ttkpark/tomato-picker/docs/line-course/paper_shadow.jpg

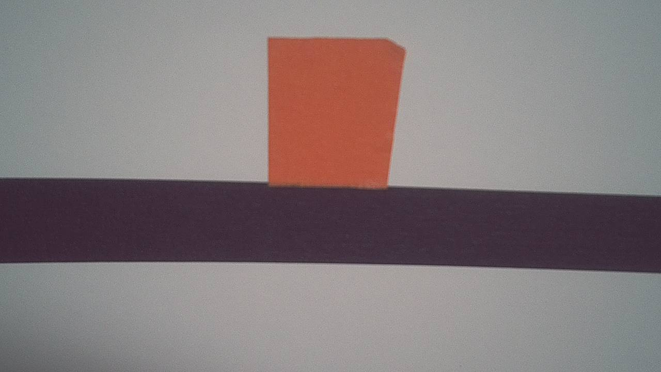
docs/line-course/paper_shadow.jpg
