ttkpark/tomato-picker/docs/line-course/paper_now.jpg

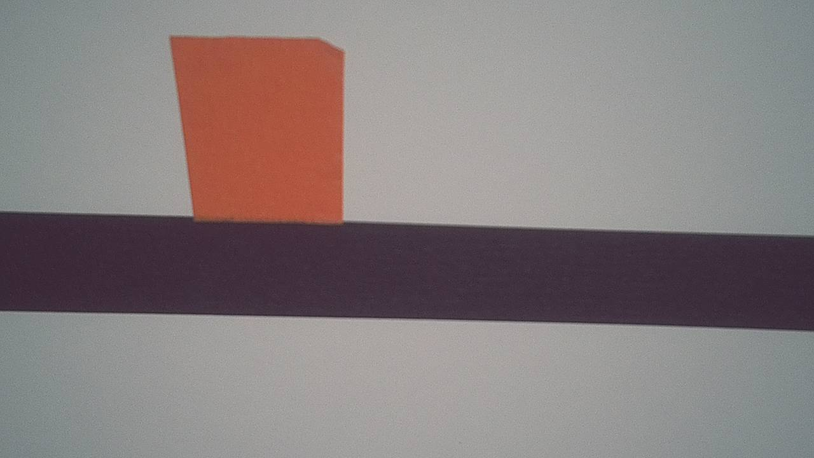
docs/line-course/paper_now.jpg
