ttkpark/tomato-picker/ros2/README.md

# ros2/ — 새 계통: **무대를 외우지 않고 좌표로 딴다**

> 이 디렉터리는 기존 파이썬 스택(`src/tomato_picker/`)을 **대체하러** 온 것이 아니라,
> 그 스택이 구조적으로 풀 수 없는 문제 하나를 풀러 왔다. 기존 스택은 계속 돈다.
> 계통 분리와 태그 규칙은 [`docs/ros2-이행계획.md`](../docs/ros2-이행계획.md).

---

## 1. 왜 갈아엎는가 — 기존 스택이 못 푸는 문제

지금 로봇은 토마토를 **화면 좌표**로 안다.

```
카메라 픽셀 (x, y)  →  harvest.SceneModel이 "몇 번 나무, 위/아래"로 분류
                    →  arm.play_blended(y)가 저장해 둔 자세를 보간 재생
```

여기 어디에도 **미터가 없다.** 그래서 이런 일이 일어난다.

| 증상 | 진짜 원인 |
|---|---|
| 무대를 옮기면 열매 번호가 어긋난다 | 나무 위치를 **관측한 픽셀 x**로 배운다 (`~/harvest_scene.json`) |
| 서비스를 재시작하면 학습이 날아간다 | 무대가 **상태**다. 재학습 첫 프레임이 오검출이면 그게 무대가 된다 |
| 열매가 20cm 앞으로 오면 헛집는다 | 자세는 **저장된 관절값**이다. 거리를 모르니 보정할 수 없다 |
| 카메라를 조금 돌리면 전부 틀어진다 | 픽셀↔자세 대응이 **그 카메라 각도에 통째로 묶여** 있다 |

이건 튜닝으로 못 고친다. **"토마토가 어디 있는가"를 미터로 말할 수 없는 구조**라서 그렇다.

## 2. 새 계통이 세우는 계약

```
D405가 준 (u, v, depth)  ──내부파라미터──▶  카메라 좌표 3D (mm)
                          ──손-눈 변환 T_base_cam──▶  팔 base 좌표 3D (mm)
                          ──IK──▶  관절 각
```

무대 학습이 없다. 저장된 자세도 없다. **좌표 하나가 끝까지 간다.**
무대를 옮겨도, 카메라를 다시 달아도, 열매가 처음 보는 자리에 있어도 같은 식이 돈다 —
단, **손-눈 변환을 다시 재야 한다**(카메라를 옮겼을 때만. 무대는 상관없다).

> 이게 "일반적인 환경에서도 변함없이"의 조작적 정의다. 무대에 대한 가정을
> **하나도 안 하는 것**이지, 무대를 더 잘 배우는 게 아니다.

## 3. 왜 ROS인가 — 세 가지, 그 이상은 아니다

ROS를 쓰는 이유는 "표준이니까"가 아니다. 위 계약을 **혼자 구현하면 반드시 틀리는**
부분이 셋 있어서다.

1. **TF** — 좌표계가 다섯 개(`base_link`, `arm_base`, 관절 5개, `tool0`, 카메라)를 넘어가면
   변환 합성과 **시각 정렬**(그 프레임을 찍은 순간의 팔 자세)을 사람이 손으로 못 맞춘다.
   기존 스택에서 `line_drive.py`가 겪은 부호 사고들이 전부 이 문제의 축소판이다.
2. **시간** — 깊이 프레임과 관절값은 **다른 시각**의 데이터다. 팔이 움직이는 중에 찍은
   프레임을 지금 관절값으로 풀면 그만큼 틀린다. `tf2`의 시간 보간이 이걸 공짜로 준다.
3. **교체 가능성** — 검출기를 HSV→YOLO로, 카메라를 D405→다른 것으로 바꿔도
   토픽 타입이 같으면 나머지가 안 바뀐다. [`docs/보드-계약.md`](../docs/보드-계약.md)가
   주행 보드에 대해 세운 원칙과 **같은 원칙**을 인식·팔에 적용하는 것이다.

ROS가 **안 하는 것**도 적어 둔다: 정지마찰 문턱을 없애 주지 않고, 영점을 대신 잡아
주지 않고, 잘못 잰 링크 길이를 고쳐 주지 않는다. 그건 여전히 우리 몫이다.

## 4. 단위 경계 — 어디서 무엇이 바뀌는가

이 프로젝트에는 이미 단위가 셋 있고, 섞이면 그 자리가 곧 버그다.

| 구간 | 단위 | 근거 |
|---|---|---|
| ROS 토픽·TF·URDF | **m, rad** | REP-103. 여기만은 타협 없음(모든 표준 노드가 이걸 가정) |
| 기구학·손눈보정 (`kinematics.py`, `handeye.py`) | **mm, °** | 기존 자산. 링크 길이를 자로 재서 넣는 곳이라 mm가 맞다 |
| 주행 보드 시리얼 | **mm/s, mdeg/s** | [`docs/보드-계약.md`](../docs/보드-계약.md) §2① |

변환은 **경계 노드 안에서 한 번만** 한다. 노드 내부에서 두 단위를 같이 쓰지 않는다.
경계는 정확히 세 곳이다 — `joint_state_node`(° → rad), `cmd_vel_node`(m/s → mm/s),
`handeye_node`(mm → m).

## 5. 구성

```
ros2/
├─ docker/            젯슨에서 도는 방법 (L4T 커널 위 Jazzy 컨테이너)
├─ src/
│  ├─ tomato_msgs         Fruit3D / FruitArray / 보정 서비스
│  ├─ tomato_description  URDF(xacro) — kinematics.py와 **같은 링크 길이**
│  ├─ tomato_bridge       기존 하드웨어를 ROS에 물리는 다리 (팔 관절 / cmd_vel)
│  ├─ tomato_perception   D405 → 열매 3D 점 (팔 좌표계로 변환해서 발행)
│  ├─ tomato_handeye      손-눈 보정 수집·풀이·static TF 발행
│  └─ tomato_bringup      런치와 파라미터
└─ tools/ros_selfcheck.py  **ROS 없이 PC에서 도는 검증** (아래)
```

### 왜 `ros_selfcheck.py`가 있는가

이 저장소의 규칙이다 — [`kinematics.py`](../src/tomato_picker/hardware/kinematics.py)가
`import math` 하나로 버티는 이유, [`handeye.py`](../src/tomato_picker/hardware/handeye.py)가
numpy 하나로 버티는 이유와 같다. **숫자가 맞는지를 확인하려고 매번 젯슨에 올려 팔을
흔들 수는 없다.** 그래서 각 패키지의 계산 부분은 `rclpy`를 import하지 않는 순수 모듈로
떼어 놓고, PC에서 이걸 돌린다.

```bash
python ros2/tools/ros_selfcheck.py        # ROS도 젯슨도 필요 없음 (69종)
```

패키지 안에서 `rclpy`가 들어간 파일은 `*_node.py` **뿐이다.** 그 규칙을 셀프체크가
직접 검사한다.

검사는 두 층이다 — 아래쪽이 위쪽의 구멍을 막는다.

| 어디서 | 무엇을 | 구멍 |
|---|---|---|
| PC | `ros2/tools/ros_selfcheck.py` — xacro를 **직접 파싱해** 계산한 값과 대조 | 내가 xacro를 잘못 읽었으면 검사도 같이 틀린다 |
| 로봇 | `ros2/tools/bringup_check.sh` → `tf_check.py` — **진짜 RSP가 만든 TF**와 대조 | 그 구멍을 막는다. 팔·카메라 없이 돈다 |

```bash
# 컨테이너 안에서 (팔도 카메라도 필요 없다)
sudo HOME="$HOME" docker compose run --rm ros bash /ws/tools/bringup_check.sh
```

## 6. 지금 되는 것 / 아직 아닌 것

| | 상태 |
|---|---|
| URDF·TF 트리, `/joint_states` 발행 | ✅ 1단계 |
| `/cmd_vel` → 주행 보드 (보드계약 `C`, 레거시 `V` 폴백) | ✅ 1단계 |
| D405 → 열매 3D 점을 **팔 좌표계로** 발행 | ✅ 1단계 |
| 손-눈 보정 수집·풀이·static TF | ✅ 1단계 |
| 좌표로 집으러 가기(IK 실행) | ✅ 1단계 (`/arm/move_to_point`) |
| 마커로 집게를 눈으로 보며 오차 닫기(시각 서보잉) | ⏳ 2단계 |
| MoveIt 궤적·충돌 회피 | ⏳ 3단계 |

단계와 태그 대응은 [`docs/ros2-이행계획.md`](../docs/ros2-이행계획.md).

## 7. ⚠ 장치는 배타적이다 — 켜기 전에 자리를 비운다

포트도 카메라도 **한 프로세스만** 연다. 설정이 아니라 물리다.

| 장치 | 레거시가 잡는 것 | ROS가 잡는 것 |
|---|---|---|
| `/dev/ttyACM0` (팔) | `tomato-voice.service` | `arm_node` |
| `/dev/ttyUSB0` (주행 보드) | `controller-drive.service` | `cmd_vel_node` |
| **D405** | `depth-cam.service` (`/dev/shm`) | `realsense2_camera` |

```bash
sudo systemctl stop tomato-voice depth-cam      # 팔 + 카메라
sudo systemctl stop controller-drive            # 주행까지 쓸 때
```

`arm_mode:=proxy`는 **레거시 대시보드를 켜 둔 채 배선만 확인하는** 임시 경로다.
관절값이 HTTP 폴링(~10Hz)이라 **TF 시각 정렬이 안 되므로** 보정·수확에는 쓰지 마라
(`v2.0.0-ros.3`에서 삭제). 포트가 막히면 도망갈 곳이 아니라 **끌 서비스**를 봐라.

## 8. 레거시와 무엇을 공유하고 무엇을 안 하는가

한 줄로: **계산과 실측값은 공유하고, 장치와 상태의 소유권은 ROS가 가지며, 웹
서비스에는 붙지 않는다.**

기구학을 여기 다시 쓰면 같은 팔을 두 계통이 다르게 믿게 된다 — 그래서
`kinematics.py`·`handeye.py`·`cartesian.py`·`eye.EyeConfig`는 **계속 쓴다**.
그건 라이브러리를 쓰는 것이지 옛 계통을 따라가는 것이 아니다. 반대로 팔을 여는 일,
보드에 쓰는 일, 카메라를 잡는 일은 ROS가 가져왔다.

보정 파일은 **한 벌**이다(`~/arm_eye.json`). 대시보드에서 잡은 보정을 ROS가 그대로
쓰고, 그 반대도 같다 — 팔도 카메라도 하나뿐이므로.

전체 표와 언제 무엇을 끊는지는
[`docs/ros2-이행계획.md`](../docs/ros2-이행계획.md) §4 "레거시 의존 졸업표".
그 표는 `ros2/tools/ros_selfcheck.py`의 **[경계]** 검사가 강제한다 — 표에 없는
의존이 들어오면 실패한다.
