ttkpark/tomato-picker/docs/arm-cartesian.md

# 팔 3D 좌표 유닛 — xyz 이동과 제자리 회전

집게가 문 물건을 **로봇 좌표 xyz로 옮기고, 그 자리에서 돌린다.**
프리셋(저장한 자세 재생)이 못 하던 "5mm만 더 앞으로", "문 채로 30° 돌려"가 여기서 된다.

| 파일 | 하는 일 |
|---|---|
| [`hardware/kinematics.py`](../src/tomato_picker/hardware/kinematics.py) | 순/역기구학. **import가 `math` 하나** — 팔 없이 PC에서 검증 가능 |
| [`hardware/cartesian.py`](../src/tomato_picker/hardware/cartesian.py) | 유닛 본체 — 정규화값↔각도, 영점, 안전검사, 조그/회전/집게 |
| [`hardware/arm.py`](../src/tomato_picker/hardware/arm.py) `_FollowerJointIO` | 실물 팔에 붙이는 어댑터 (`arm.cartesian`) |
| [`tools/arm_cartesian_check.py`](../tools/arm_cartesian_check.py) | 하드웨어 없이 도는 자체검증 33종 |
| `/control` 3D 좌표 이동 · `/settings` 3D 좌표 영점 | 화면 |

---

## 1. 좌표계 — 무엇이 x이고 무엇이 y인가

```
        +z 위
         │
         │        원점 = shoulder_pan(요) 축이 바닥판을 지나는 점
         │        +x = pan=0일 때 팔이 뻗는 방향(앞)
         └──── +x 앞      +y = 왼쪽
        /
      +y 왼

pitch = 집게 축이 수평에서 들린 각   (0° = 수평, -90° = 바닥을 봄)
roll  = 집게 축을 중심으로 한 비틀림 (= wrist_roll 그대로)
```

관절 각의 **기준은 수평**이다(`shoulder_lift = 0°`면 상완이 수평).
이것과 **영점을 잡을 때 두는 자세(교시 자세)** 는 별개다 — 아래 3절.

---

## 2. ⚠ 이 팔이 못 하는 것 — 5축이라 6자유도가 안 나온다

**집게가 향하는 좌우 방향(yaw)은 위치에 묶여 있다.** `shoulder_pan`은 팔 전체를
돌리므로 집게는 항상 원점에서 바깥을 향한다. 그래서 "물체를 제자리에서 좌우로
비틀기"는 일반적으로 **불가능**하다.

**딱 하나 예외** — 집게가 바닥을 볼 때(`pitch ≈ -90°`)는 집게 축이 곧 수직축이라
`wrist_roll`이 그대로 yaw가 된다. 위에서 내려다보며 집는 자세에서는 제자리 yaw가
공짜로 된다. 화면의 [돌리기 ↺/↻]는 이 구간에서만 열리고, 아니면 왜 안 되는지
말해준다.

그래서 제자리 회전은 **세 가지**다:

| 화면 버튼 | 축 | 되는 조건 | 어떻게 |
|---|---|---|---|
| 비틀기 ↺↻ | roll | 언제나 | `wrist_roll` 하나만 돈다 — 가장 확실 |
| 손목 들기/숙이기 | pitch | 사거리 안이면 | IK로 **끝점을 고정한 채** 손목 각만 바꾼다 |
| 돌리기 ↺↻ | yaw | `pitch ≈ -90°`일 때만 | roll을 반대 부호로 돌린다 |

---

## 3. 처음 한 번 — 영점 잡기 (안 하면 좌표 이동이 아예 안 열린다)

`/settings` → **3D 좌표 영점**

1. **부호 먼저.** [① 힘 빼기] 후 관절을 하나씩 손으로 움직이며 화면의 각도 숫자를 본다.
   - `shoulder_lift` — 상완을 **위로** 들 때 숫자가 커져야 한다
   - `elbow_flex` — 전완을 **위로** 접을 때 커져야 한다
   - `wrist_flex` — 집게를 **위로** 젖힐 때 커져야 한다
   - `shoulder_pan` — **왼쪽**으로 돌 때 커져야 한다
   - `wrist_roll` — 반시계로 비틀 때 커져야 한다

   반대로 가는 관절만 [뒤집기]. **부호가 틀리면 "위로"가 아래로 간다** — 영점보다 먼저 맞춘다.

2. **링크 길이.** 자로 잰다(축과 축 사이, mm). 5분이면 된다.
   `z0`=바닥판→어깨축, `l1`=어깨→팔꿈치, `l2`=팔꿈치→손목,
   `l3`=손목→**집게가 무는 지점**(손끝이 아니다).
   틀리면 조그 **방향은 맞고 크기만** 비례해서 어긋나고, 절대 좌표 이동은 그만큼 틀린다.

3. **영점 — 어깨는 정면, 나머지는 곧게 위로.**
   힘 뺀 팔의 어깨(`shoulder_pan`)를 정면으로 두고, **상완·전완·집게를 한 줄로 수직**
   으로 세운다(팔꿈치·손목을 꺾지 않는다). 그 자세에서 [② 지금 자세를 영점으로].
   기구학 각도로는 `pan 0 / lift 90 / elbow 0 / wrist_flex 0`
   (= `config.ARM_CART_ZERO_POSE_DEG`, 파일에도 `ref_deg`로 함께 기록된다).

   > **왜 수평이 아니라 수직인가** (2026-08-22 현장에서 바꿈)
   > - 힘을 빼면 **중력이 수평 팔을 끌어내린다.** 손으로 붙들고 버튼을 누르는 사이
   >   이미 몇 도가 처지고, 그 처짐이 그대로 영점 오차가 된다.
   > - **수직은 기준선이 있다.** 문틀·벽 모서리에 대보면 1° 안쪽으로 맞는다.
   >   수평은 기준이 없어 사람마다, 누를 때마다 다르게 잡힌다.

   > ⚠ **세운 직후에는 조그가 막힌다 — 정상이다.** 그 자세는 집게가 회전축 바로 위
   > (수평거리 0)라 "앞"이 어느 쪽인지 정의되지 않는 **특이점**이다. 프리셋으로 앞으로
   > 뻗은 자세를 만든 뒤 좌표 이동을 쓴다.

결과는 `~/arm_cartesian.json`에 남는다. `config.py`의 값은 공장 초기값이고,
이 파일이 있으면 **파일이 이긴다**(`~/base_tuning.json`과 같은 구조).

> ⚠ **팔 범위 캘리브레이션을 다시 하면 이 영점도 다시 잡아야 한다.**
> 정규화값(-100..100)이 무슨 각도인지가 통째로 바뀌기 때문이다.
> 프리셋 숫자가 다른 자세를 가리키게 되는 것과 같은 이유다.

---

## 4. 쓰는 법

**화면** — `/control` → **3D 좌표 이동**

- 이동 스텝(mm) / 회전 스텝(°) 슬라이더 → 축 버튼 한 번에 그만큼
- **집게 기준으로 움직이기** 체크 → 로봇 xyz 대신 집게 기준
  (앞=찔러넣기, 위=집게 기준 위). 비스듬히 든 집게로 열매에 똑바로 다가갈 때 쓴다.
  체크하면 버튼 라벨도 같이 바뀐다 — 어느 기준으로 누르는지 헷갈리면 안 되니까.
- 좌표로 직접: [지금 값 채우기] → 숫자 고침 → [여기로]

**코드**

```python
arm.cartesian.jog(dz=10)                      # 위로 10mm
arm.cartesian.jog(dx=20, frame="tool")        # 집게가 보는 쪽으로 20mm
arm.cartesian.move_to(x=210, z=140)           # 절대 좌표(안 준 축은 유지)
arm.cartesian.spin(30, axis="roll")           # 문 채로 30° 비틀기
arm.cartesian.spin(-15, axis="pitch")         # 끝점 고정하고 손목만 숙이기
arm.cartesian.spin(90, axis="yaw")            # 내려다보는 자세에서만
arm.cartesian.set_grip(0)                     # 집게 닫기(0=닫힘, 100=열림)
pose = arm.cartesian.pose()                   # ToolPose(x, y, z, pitch, roll)
```

**집게는 좌표 이동이 절대 건드리지 않는다.** 매 조그마다 집게에 새 목표를 주면
눌린 현재값을 목표로 다시 써서 무는 힘이 조금씩 풀리고, 몇 번 반복하면 떨어뜨린다.
집게는 `set_grip()`으로 명시적으로 요청할 때만 움직인다.

---

## 5. 안 움직일 때 — 이유는 항상 화면에 뜬다

이 유닛은 **못 가는 곳으로 되는 데까지 가지 않는다.** 전부 거절하고 이유를 말한다.

| 메시지 | 뜻 | 조치 |
|---|---|---|
| 너무 작아서 실제로는 안 움직입니다 | 필요한 관절 변화가 서보 분해능(0.088°/틱) 근처 | 스텝을 키운다 |
| 한 번에 N mm는 너무 큽니다 | 좌표 오타 방어(상한 80mm) | 나눠서 간다 |
| 거기까지 못 갑니다 — 사거리 밖 | IK가 안 풀린다 | 가깝게 잡거나 pitch를 바꾼다 |
| 관절 가동범위를 벗어납니다: … | 그 관절이 캘리브레이션된 끝 | 그 방향으로는 끝 |
| 바닥 아래입니다 / 몸통에 너무 가깝습니다 | 작업영역 밖 | — |
| 팔이 거의 수직으로 서 있습니다 | 영점 자세 그대로 — 회전축 위라 방향이 없다 | 프리셋으로 앞으로 뻗은 자세부터 |
| 팔이 몸통 뒤로 넘어가 있습니다 | 끝점이 pan 축 뒤로 넘어가 좌표가 뒤집히는 구간 | 〃 |
| 기구학 영점이 없습니다 | 3번을 안 했다 | `/settings`에서 등록 |

> **왜 이렇게 깐깐한가** — CLAUDE.md의 "지령은 나가는데 아무 일도 안 일어난다"가
> 이 로봇의 1번 병이고, 서보에도 같은 문턱이 있다. 0.1mm 조그는 관절로 0.02°,
> 서보 1틱(0.088°) **아래**라 물리적으로 0이다. 그걸 "완료"라고 말하면 사람이
> 게인을 만지기 시작하고, 한 시간이 사라진다.

---

## 6. 팔 없이 검증하기

```bash
python tools/arm_cartesian_check.py
```

기구학 왕복(무작위 2만 자세) · 조그가 요청한 방향으로 요청한 만큼 가는지 ·
제자리 회전이 정말 제자리인지(끝점 이동 0mm) · 안전 검사가 실제로 막는지 ·
교시 자세(곧게 세운 팔)를 영점으로 잡으면 각도와 좌표가 맞게 나오는지 —
**33가지를 하드웨어 없이** 확인한다. 대시보드도 Mock 팔에 같은 유닛이 붙어 있어
(`SimJointIO`) 화면과 왕복을 PC에서 그대로 눌러볼 수 있다.

부호·라디안/도·왕복 불일치 같은 실수는 실물에서 확인할 이유가 없다 — 그건
부러진 집게로 배우게 된다.
