ttkpark/tomato-picker/PROJECT_토마토로봇.md

# PROJECT — 토마토 따기 로봇 (LG Physical AI 부스)

> 프로젝트 마스터 문서. 현황·팀·하드웨어·아키텍처·할 일·일정을 한 곳에. (수시 갱신)
> 최종 갱신: 2026-06-26

---

## 한 줄 요약
음성 명령을 LLM이 받아 로봇이 익은 토마토를 직접 보고 따서 바구니에 담는 **체험형 피지컬 AI 데모**.
메시지: *"쉽게 구할 수 있는 로봇팔로도 피지컬 AI가 가능하다."*

## 기본 정보
| 항목 | 내용 |
|---|---|
| 의뢰 | 포너즈 → 박기호 |
| 공동진행 | 용용이님 |
| 용도 | LG AI 컨퍼런스 체험형 부스 레퍼런스(데모) |
| 마감 | **2026-08-초** (가용 약 1~1.5개월) |
| 예산 | 300~400만원 (단위 확인 필요) / 집행 약 135만원 |
| 상태 | 🟢 부품 대부분 입고 · **조립 진행 중** |

---

## 현황 (Status)
- ✅ 컨셉/아키텍처 확정 (2026-06-24)
- ✅ 핵심 장비 발주·입고
- ✅ **카메라 발주·도착** (이전 블로커 해소)
- ✅ 추가 부품 도착 — NVMe 스토리지·와이파이 안테나·삼각대·컴퓨터 케이스
- 🟢 **조립 진행 중** (로봇팔 제외 전 부품 도착) — 작업 영상도 기록 중 🎥
- 🟡 로봇팔(SO-ARM101) 도착 대기
- 🟡 전원/파워(UPS) — 조만간 구매 예정
- 🟡 젯슨 오린 세팅 예정
- 🔴 제어 / 인식 / 수확 알고리즘 미착수

---

## 설계 원칙 (안정성 최우선)
부스 데모는 결정적이어야 한다. **"AI"는 딱 두 층에만** 둔다.
1. 익은 열매 인식 — 색 기반 검출 (빨강=수확 / 초록=미수확)
2. 자연어 → 함수 계획 — LLM(Claude) 함수콜 오케스트레이션

나머지(이동·집기)는 **전부 하드코딩/결정적**.
- 무대: 나무 모형 3개 일렬, 열매 위치 자석 고정.
- 이동: 메카넘 베이스 **직선 운동만** (자유주행 X).
- 따기: 사전 정의 시퀀스 재생.

## 아키텍처
```
음성 명령
  └─> Claude (함수콜 오케스트레이션)
        ├─ drive_to_tree(id)   직선 이동
        ├─ scan_tree()         카메라 색검출 → [열매: 위치·익음]
        ├─ pick_fruit(id)      따기 시퀀스
        ├─ place_in_basket()   바구니 적재
        └─ home()              복귀
              └─> 하드웨어: 팔 + 이동베이스 + 카메라
```
예) "수확 가능한 모든 열매를 수확해" → 나무 순회하며 빨강 열매만 수확.

---

## 하드웨어
| 구분 | 품목 | 상태 |
|---|---|---|
| 로봇팔 | LeRobot SO-ARM101 Max (Feetech 서보) | 🟡 도착 대기 |
| 연산보드 | NVIDIA Jetson Orin Nano Super 개발자킷 | ✅ 입고 |
| 스토리지 | NVMe 128GB (중고) | ✅ 입고 |
| 케이스 | 젯슨 오린 나노 NX 케이스 + 컴퓨터 케이스 | ✅ 입고 |
| 이동베이스 | RC 메카넘 휠 프레임 + 모터컨트롤러(아두이노 우노) | ✅ 입고 |
| 카메라 | USB 웹캠 (위치 인식용) | ✅ 입고 |
| 삼각대 | 카메라 거치용 | ✅ 입고 |
| 와이파이 | 와이파이 안테나 | ✅ 입고 |
| 전원 | UPS/파워 5V 5A↑ (팔+모터 동시) | 🟡 구매 예정 |

배송지: 경기 수원시 팔달구 창룡대로103번길 92, 매향동 201호 (16254) · 박기호 010-6891-7112

## 소프트웨어
- 스킬 함수 API: `drive_to_tree` / `scan_tree` / `pick_fruit` / `place_in_basket` / `home` → Claude에 tool로 노출.
- 인식: 색 코딩 검출(빨강/초록). 여유 시 YOLO·뎁스(D435) 고도화.
- ⚠️ **오프라인 폴백(필수):** 부스 와이파이 불안 대비, 망 없이 도는 자동 시퀀스(데모 모드).

---

## 일정 / 역할
- **박기호 독일 체류 7/9 ~ 7/27** → 직접 작업 불가.
  - 출국 전: 스펙 확정 + 부품 발주 완료(카메라 ✅) + 조립.
  - 체류 중: 용용이님 진행.
  - 귀국(7/27) 후: 통합·튜닝·리허설.
- 작업 순서: **조립(진행중)** → 제어 → 위치 인식 → 수확 알고리즘 → 폴백/리허설.

## 할 일 (TODO)
- [x] 카메라 발주·입고
- [x] NVMe·와이파이 안테나·삼각대·케이스 입고
- [ ] 🟢 차체·연산·카메라 조립 (진행 중)
- [ ] 로봇팔 도착 후 팔 조립
- [ ] 전원/파워(UPS) 구매 (5V 5A↑)
- [ ] 젯슨 오린 세팅 (스토리지·와이파이 포함)
- [ ] 스킬 함수 구현 + Claude tool 연동
- [ ] 색검출 인식 구현
- [ ] 오프라인 데모 모드 폴백
- [ ] 부스 리허설

## 확인할 것 (Open Questions)
- [ ] 예산 단위(300~400만원?)
- [ ] 용용이님 역할·독일 기간 중 진행 범위
- [ ] 음성인식이 데모 필수 요소인지
- [ ] 부스 데모 날짜(컨퍼런스 주차)
- [ ] LeRobot 셋업 환경 — Jetson(ARM64) vs PC(x86)

---

## 구매 내역 (누적 약 135만원)
| 품목 | 가격 | 출처 |
|---|---|---|
| SO-ARM101 Max | 550,000 | 네이버 로보이지 |
| Jetson Orin Nano Super 킷 | 475,000 | 쿠팡 키트로닉 |
| 메카넘 휠 프레임+모터컨트롤러 | 246,650 | — |
| NVMe 128GB (중고) | 33,870 | 11번가 |
| 와이파이 안테나 | 20,000 | 쿠팡 |
| 젯슨 케이스 | 29,000 | — |
| 카메라·삼각대 | — | — |
| 전원/파워 | (예정) | — |

## 관련 문서
- 스마트로봇_명세서.md — 정식 명세서
- 토마토로봇_내이야기모음.md — 결정·아이디어 히스토리
