ttkpark/tomato-picker/토마토로봇_내이야기모음.md

# 토마토 따기 로봇팔 — 내가 했던 이야기 모음

(LG Physical AI 부스 / 포너즈 의뢰 / 용용이님과 진행 — 그동안 직접 하신 말·생각·결정 모은 것)

---

## 프로젝트가 시작된 배경 (내가 들려준 것)
- 포너즈에서 박기호 앞으로 들어온 의뢰. **용용이님과 함께** 진행.
- LG의 AI 컨퍼런스(주차별 개최)와 연이 닿음. LG 산하기업 연차 있는 분들이 모여 체험형 부스 준비.
- 그 안에 들어갈 **Physical AI 부스 후보로 선정** → 레퍼런스(데모 작품) 제작.
- 내가 지향한 것: "GPT처럼 화면 속 AI" 말고, **로봇이 직접 인식하고 액션하는** 피지컬 AI. 비즈니스 가치 있으면 좋겠다.
- 지금 피지컬 AI 초기 단계라 **투박해도 된다**, 정밀 검증·완성도보다 아이디어·개념 증명 위주여도 OK.

## 아이디어를 좁혀간 과정
- 처음엔 후보를 여러 개 던졌음: 로봇청소기, 로봇손, 자율주행 등.
- 기존 아이디어: **과일 따주는 로봇팔**, 범위 안 물건 집어주기.
- 유력 컨셉으로 구체화한 게 **"토마토 따기"**:
  - 나무(1번)에 열매(2번) 위치를 **자석으로 고정 표시**.
  - 위치·따는 동작을 정형화. → 데모가 결정적(reliable)이라 부스에 적합.
- 동작 흐름 구상: **음성인식(Claude 함수콜) → 로봇이 인식 → 과일 집기 → 바구니에 담기.**
  "언어 → 인식 → 액션"으로 피지컬 AI 서사를 깔끔하게.
- 내가 정한 핵심 메시지: **"쉽게 구할 수 있는 로봇팔로도 가능했다."**

## 확정한 컨셉/아키텍처 (내가 정리해 말한 것)
- 무대: **나무 모형 3개 일렬**, 정해진 위치에 열매 고정.
- 메카넘 베이스는 **직선 운동만**으로 나무까지 이동 (자유주행 X → 실패요인 최소화).
- 따기 동작은 **하드코딩**.
- 핵심은 **LLM(Claude) 함수콜 오케스트레이션.** 음성 명령 → Claude가 로봇 스킬 함수들을 호출해 복합 작업.
  - 예: "수확 가능한 모든 열매를 수확해" → 카메라로 익은 열매 검출 → 나무 순회하며 수확.
- 즉, 저수준 동작(이동·집기)은 전부 결정적/하드코딩으로 신뢰성 확보.
  "AI"는 ① 색기반 익은열매 인식 ② LLM 자연어→함수 계획, **이 두 층에만**.
- 스킬 함수 API 초안(내가 그린 것):
  `drive_to_tree(id)` / `scan_tree()`→열매목록(위치·익음) / `pick_fruit(id)` / `place_in_basket()` / `home()`.
- 익은열매 = **색 코딩**(빨강=수확 / 초록=미수확) 권장 → 인식이 단순 색검출이라 신뢰성 높음.

## 장비 — 내가 결정하고 산 것
- **LeRobot SO-ARM101 기반 채택** (HuggingFace LeRobot 오픈소스 암, Feetech 서보, 조립형, 텔레오퍼레이션+모방학습 ACT 지원).
- 구매 내역 (총 약 130만원 / 예산 300~400만원 내 — 여유 있음):
  1. LeRobot **SO-ARM101 Max** — 55만원 — 6/26(금) 도착
  2. **NVIDIA Jetson Orin Nano Super 개발자킷** — 47.5만원 — 6/25 도착 (연산보드/에지 AI)
  3. 젯슨 오린 나노 NX 케이스 — 2.9만원 — 6/25 도착
  4. **RC 메카넘 휠 로봇 프레임 + 모터컨트롤러(아두이노 우노)** — 24.6만원 — 6/25 도착 (이동 베이스)
- 배송지: 경기 수원시 팔달구 창룡대로103번길 92, 매향동 201호, 박기호 앞.

## 최근에 한 이야기 (작업 진행)
- 오늘(6/26) 할 일로 언급: **알리익스프레스에서 UPS 찾기** — 젯슨 오린 5V 5A에 모터 5V도 같이 지원 가능한 UPS.
- **젯슨 오린 세팅**도 해야 함.

---

## 내가 아직 안 정한 / 확인하기로 한 것
- 예산 단위(300~400만원 맞는지)
- 용용이님 역할·전문성, 독일 기간(7/9~27) 중 진행 가능 여부
- 음성인식이 데모 필수 요소인지
- 부스 데모 날짜(컨퍼런스 주차)

## 비서가 짚어둔 공백 (참고)
- **카메라 미구매.** 위치 인식에 필수인데 목록에 없음. 출국(7/9) 전 도착하게 주문 필요.
- 부스 인터넷 의존 → 와이파이 불안 대비 **오프라인 자동 시퀀스(데모 모드) 폴백** 준비.
- 박기호 **7/9~27 독일 체류** → 그 기간 직접 작업 불가. 출국 전 스펙 확정·발주 후 용용이님 진행, 귀국 후 통합.
