ttkpark/tomato-picker/docs/인수인계-2026-09-03.md

# 인수인계 — 줄기 잡기 (2026-09-03 새벽)

다른 PC에서 이어받는 사람을 위한 문서. **로봇을 만지기 전에 이 문서의 "함정"부터 읽어라.**

---

## 0. 한 줄 상태

겨냥(시각 서보)은 **된다**. 화소오차 144 → 8까지 여러 번 수렴했다.
안 되는 것은 **표적 선택**과 **마지막 40mm 전진**이다.
그래서 표적은 사람이 웹에서 찍어 주고(`click-server`), 전진은 계속 다듬는 중이다.

---

## 1. 지금 켜져 있는 것

| 이름 | 무엇 | 확인 |
|---|---|---|
| 젯슨 | `server@192.168.0.6` (DHCP라 바뀔 수 있음) | `ssh -i <키> server@192.168.0.6` |
| `depth-cam` | D405 → `/dev/shm/d405_{color.jpg,depth.npy,meta.json}` | `systemctl is-active depth-cam` |
| **`click-server`** | **조작대 + API, 포트 8090** | http://192.168.0.6:8090/ |
| `tomato-voice` | **꺼져 있어야 한다** (팔 포트를 뺏는다) | `systemctl is-active tomato-voice` → `inactive` |

⚠ `tomato-voice`는 **`enabled`(부팅 자동실행)** 라서 젯슨을 재부팅하면 되살아난다.
살아 있으면 조작대에서 시키는 일이 전부 조용히 실패한다 — 그래서 **조작대 맨 위에
빨간 경고가 뜨게** 해 뒀다. 뜨면 `sudo systemctl stop tomato-voice`.

SSH 키는 이 PC 기준 `C:\Users\GH\.ssh\id_ed25519` 였다. 다른 PC라면 그 PC의 키를
젯슨 `~/.ssh/authorized_keys`에 넣거나, **키 없이도 웹 조작대만으로 대부분 된다.**

---

## 2. 다른 PC에서 시작하는 법

```bash
git clone <origin> && cd tomato-picker
git checkout feat/ros2-arm-estimation
```

그 다음 브라우저로 **http://192.168.0.6:8090/** 를 연다. 끝이다.
팔 조작·잡기·집게·자세는 전부 그 화면에서 된다. 터미널이 꼭 필요한 일은 없다.

젯슨의 코드를 고쳤으면 올려야 한다(git clone이 아니라 **scp**로 배포한다):

```bash
tr -d '\r' < ros2/tools/stem_grasp.py > /tmp/x.py
scp /tmp/x.py server@192.168.0.6:~/tomato-picker/ros2/tools/stem_grasp.py
# click_server.py 를 고쳤으면
ssh server@192.168.0.6 'sudo systemctl restart click-server'
```

⚠ **CR 제거(`tr -d '\r'`)를 빼먹지 말 것** — 윈도우에서 그냥 scp 하면 젯슨에서 깨진다.

---

## 3. 조작대 API — 사람과 에이전트가 같은 문을 쓴다

이 세션의 후반부터 **모든 조작을 이 API로만** 내렸다. 화면의 버튼, `curl`,
에이전트가 전부 같은 경로다. 재현이 안 되는 조작을 남기지 않기 위해서다.

```
GET  /state                 상태 (프레임 나이, 표적, 십자, 도는 일)
GET  /log?since=N           로그 이어받기
GET  /frame.jpg             손목 화면
POST /click  {u,v,mode}     mode=target(줄기) | grip(십자 위치)
POST /clear                 표적 지움
POST /run    {job,args}     아래 표
POST /stop                  도는 일 끊기
```

| job | args | 하는 일 |
|---|---|---|
| `park` | — | 대기 자세 `60,65,0,-100,6`(도) |
| `stage` | `target:"60,65,0,-100,6"` | 그 관절 자세로 |
| `pose` | — | 지금 자세·TCP 읽기 |
| `jog` | `dx dy dz along horiz pitch piece free_pitch` | 손끝을 mm로 옮긴다 |
| `grip` | `value:0~100` | 집게 (78=열림, 4=닫힘) |
| `grasp` | `steps adv max_turn gain tol stop_z rejacobian no_close dry` | 찍은 줄기로 가서 문다 |

```bash
curl -s -XPOST 192.168.0.6:8090/run -H 'Content-Type: application/json' \
     -d '{"job":"grasp","args":{"steps":18,"adv":8,"tol":28,"stop_z":88}}'
```

⚠ **한 번에 하나만 돈다.** 팔 포트(`/dev/ttyACM0`)를 한 프로세스만 열 수 있어서,
도는 중에 새 일을 넣으면 **409**로 거절하고 이유를 돌려준다.

---

## 4. 오늘 실측으로 확정한 값 (다시 재지 말 것)

| 값 | 실측 | 어떻게 쟀나 |
|---|---|---|
| **집게가 무는 화면 자리** | `(471, 395)` (사람이 `(416,409)`로 보정함) | 집게를 여닫아 손목 화면의 변한 화소 |
| **카메라 → 손끝 거리** | **75~80 mm** (손가락 끝 66mm) | 손가락이 찍힌 프레임의 깊이 |
| 열매 지름 | 70 mm | 134.6mm에서 폭 227화소, fx 438 |
| D405 `fx` | 437.95 | meta.json |
| 중력 처짐 | 어깨 −2.5°, 팔꿈치 −1.8°, 손목 −1.0° | 명령 대비 실제 |
| 팔이 닿는 높이 | z ≤ 480 mm | 역기구학 스캔 627자세 |

⚠ **파일에 남아 있는 `~/grasp_point.json`의 z=263mm는 틀린 값이다.** 벽 누르기
접촉 판정이 일찍 울려서 손끝을 벽까지 밀어 넣어 계산했다. 쓰지 말 것.

---

## 5. 오늘 고친 병 (같은 함정에 다시 빠지지 않게)

1. **중력 처짐이 걸음을 잡아먹는다.** 명령보다 2~3° 아래 서기 때문에, 걸음이
   그보다 작으면 **순효과가 음수**다 — 70mm 올리랬더니 15mm 내려갔다.
   → 모자란 만큼 명령에 더해 다시 보내는 **적분 보정**(`press_to`/`go`). 지금 70에 67.7mm.

2. **병진은 자세를 묶어야 한다.** 4관절 최소노름 병진은 남는 자유도로 카메라를
   확 돌린다 — 12mm 나아가랬는데 손목 카메라가 천장을 봤고, 그게 "닿았다" 오판까지
   만들었다. → 피치 고정 구속 한 줄(`step_keep`, `move_base`).

3. **한계는 거부가 아니라 처리.** 축 하나가 한계라고 걸음을 통째로 버리면 14걸음
   내리 0mm다. → 겨냥은 **잘라서라도** 가고(`clamp`), 전진은 **걸음을 줄인다**.
   ⚠ 단 전진에서 자르면 병진이 회전이 된다 — 그래서 전진만 다르게 처리한다.

4. **곧게 편 팔은 특이점**이다(elbow≈0°). 접근축으로 10mm 가는 데 84°가 필요했다.
   굽힌(elbow-down) 자세면 3.2°면 된다.

5. **깊이 판독이 튄다.** 가는 줄기는 한 프레임이 배경을 물면 63mm가 355mm로 읽힌다.
   → 3장 중앙값 + "**늘어난 건 접촉이 아니다**" + 2회 연속 정체만 접촉.

6. **밀지 말고 문다.** 손끝 거리를 아는데 접촉을 기다릴 이유가 없다.
   → `--stop-z 88`: 겨눈 자리가 그 거리에 들면 그 자리에서 닫는다.
   이 규칙이 없어서 **열매를 세 번 떨어뜨렸다.**

7. **추적이 미끄러지면 야코비안 부호가 뒤집힌다.** 깊이창 무게중심으로 따라가니
   줄기를 따라 미끄러져 겨냥이 152→95→143→101px로 진동했다.
   → **템플릿 정합(배율 3단)** 으로 교체. 지금 정합도 1.00.

8. **화면에 빨간 것이 여럿이다** — 매달린 열매 둘, 책상에 떨어진 열매, 선반의
   **주황 안전조끼**. 서보가 화소오차 8까지 말끔히 수렴했는데 겨눈 것이 조끼였고
   (집게는 바닥에 코를 박고 있었다), 다음엔 책상 열매였다(팔이 자기 몸통에 닿았다).
   → 둥글기 조건으로 조끼를 거르고, **어느 열매인지는 사람이 클릭**한다.

9. **손목 화면 상하 반전 여부로 두 번 헤맸다.** 결론: **뒤집히지 않았다.**
   집게 손가락(화면 아래)과 열매(화면 위)가 한 프레임에 같이 찍힌 사진으로 확정했다.
   "링이 열매 아래로 보인다"고 판단했던 건 *아래쪽* 링이었다.

---

## 6. 아직 안 된 것 · 다음 수

**남은 것은 마지막 40mm다.** 겨냥이 20px 안으로 들어오고 깊이가 110~130mm까지
오는데, 거기서 88mm까지 좁히는 전진이 관절 한계에 막히거나 깊이 잡음에 흔들린다.

시도해 볼 순서:

1. **굽힌 자세에서 시작한다.** 대기 자세(`60,65,0,-100,6`)는 팔이 곧게 펴진
   특이점이라 전진이 안 된다. 역기구학으로 찾아 둔 굽힘 자세 예:
   `stage {"target":"59.6,35.7,39.8,-100.5,0.0"}` (r250·z250, 10mm에 3.2°).
   ⚠ 이 자세는 열매에 아주 가깝다(줄기가 82mm로 읽혔다). 열매 위치가 바뀌면 다시 찾아야 한다.
2. **전진 방향을 실측으로 고른다.** `stem_grasp.py`에 이미 들어 있다 — 접근축이
   막히면 `접근/수평/위/아래/수평뒤/옆` 여섯 방향을 12mm씩 찔러 보고 **깊이가
   가장 많이 주는 쪽**으로 간다. 로그에 그 표가 찍힌다.
3. 그래도 안 되면 **손목 각도(`jog pitch`)를 바꿔** 접근 방향 자체를 돌린다.

**해도 소용없다고 확인된 것** (다시 하지 말 것):
- 전역 손-눈 보정: 잔차 44mm에서 안 내려갔다. 회전·링크길이·영점·측면오프셋·
  화면위치 전부 배제했는데 원인을 못 찾았다.
- 국소 손-눈 회전 실측(`cam_frame.py`): 깊이 잡음이 걸음과 비슷한 크기라
  특이값이 1.84/0.91로 나오고 잔차 20mm였다. **회전이 안 나온다.**
- **객체인식으로 줄기 찾기**: 젯슨의 `yolov8s-worldv2.pt`(개방어휘)로
  "tomato stem", "green plant stem" → **0개**. 열매는 PC 화면에서 conf 0.16으로
  잡히지만 손목 근접 화면에서는 0개다(torch가 **CPU판**, 추론 1.6초/장).
  `ultralytics`는 설치해 뒀으니 CUDA torch를 올리면 다시 볼 만하다.

---

## 7. 파일 지도 (이번에 새로 생긴 것)

| 파일 | 무엇 |
|---|---|
| [`ros2/tools/click_server.py`](../ros2/tools/click_server.py) | **조작대 + API** (systemd `click-server`, :8090) |
| [`deploy/click-server.service`](../deploy/click-server.service) | 그 서비스 정의 |
| [`ros2/tools/stem_grasp.py`](../ros2/tools/stem_grasp.py) | **겨냥 → 전진 → 물기.** 이번 작업의 본체 |
| [`ros2/tools/tool_jog.py`](../ros2/tools/tool_jog.py) | 손끝을 base 좌표로 옮긴다(자세 유지·수평·피치) |
| [`ros2/tools/grip_set.py`](../ros2/tools/grip_set.py) | 집게만 여닫는다 |
| [`ros2/tools/grasp_probe.py`](../ros2/tools/grasp_probe.py) | 벽을 눌러 파지점을 재던 도구(z는 못 믿는다, §4) |
| [`ros2/tools/cam_frame.py`](../ros2/tools/cam_frame.py) | 카메라→base 회전 국소 실측(실패, §6) |
| [`ros2/tools/visual_servo.py`](../ros2/tools/visual_servo.py) | 초기 시각 서보(색 검출 `look`/`look_stem` 제공) |
| [`tools/pc_cam.py`](../tools/pc_cam.py) · [`tools/pc_tip.py`](../tools/pc_tip.py) | PC 웹캠으로 바깥에서 보기 |

젯슨에 남는 상태 파일: `~/click_target.json`(찍은 줄기) · `~/grip_uv.json`(십자)
· `~/arm_cartesian.json`(영점·스케일) · `~/tip_depth.json`(마지막 접촉 기록).

---

## 8. 이어받는 사람에게 — 순서

1. 방에 **불을 켠다**. 컬러가 어두우면 클릭도 추적도 안 된다(01:20에 이걸로 멈췄다).
2. http://192.168.0.6:8090/ → **대기 자세**.
3. **① 줄기 찍기** → 화면에서 줄기 클릭. ⚠ **자세가 바뀌면 다시 찍어야 한다** —
   클릭은 그 프레임의 화소 자리라서, 팔이 움직이면 그 화소는 다른 것을 가리킨다.
4. 필요하면 **② 십자 옮기기**로 손가락 사이를 다시 찍는다.
5. **잡으러 간다.** 가는 중에 엉뚱한 걸 물면 **다시 클릭만** 하면 그 즉시 표적이 바뀐다
   (매 걸음 파일을 다시 읽는다).
6. 이상하면 **지금 하는 일 끊기** → **대기 자세**.

---

## 9. 넘길 때의 상태 (2026-09-03 01:5x)

- 팔: **대기 자세**로 세워 둠. TCP (112.0, 191.0, 230.0) · 피치 −41.1° · **집게 열림(78)**.
- `tomato-voice` 정지, `depth-cam`·`click-server` 동작.
- 젯슨의 도구 파일 5종이 저장소와 **md5 일치**(click_server·stem_grasp·tool_jog·grip_set·cam_frame).
- 자체검증 175종 통과: `ros_selfcheck` 70 · `handeye_check` 45 · `eye_check` 60.
- 마지막에 방 불이 꺼져 손목 화면이 새까맸다 — **불부터 켤 것.**
