ttkpark/tomato-picker/docs/재플래시-복구-핸드오프-2026-07-29.md

# 재플래시 복구 핸드오프 — 2026-07-29

젯슨이 **전원 브라운아웃 누적으로 NVMe 부팅 구조가 손상 → 벽돌화**됐고,
Windows SDK Manager로 **재플래시** 후 프로젝트를 처음부터 재설치했다.
다음 작업자(사람/에이전트)가 헷갈리지 않도록 현재 상태를 남긴다.

## 지금 젯슨 상태 (실기)

- **OS 새로 깔림**: Ubuntu 24.04.4 + L4T R39 / **JetPack 7**, Python 3.12. (이전은 구버전)
- 접속: `ssh server@192.168.0.8` (SSH키 재등록 완료, passwordless sudo 복구). **IP는 DHCP라 바뀔 수 있음** → 공유기 고정IP 예약 권장.
- **전원 문제 해결됨**: 젯슨을 모터/베이스와 **독립 전원으로 분리** → 베이스 주행해도 리셋 안 남(실측 검증). 이게 벽돌화 근본원인이었다.

## 지금 동작하는 것 ✅ (팔까지 전체 복구 완료)

- **음성 서비스 `tomato-voice`** 부팅 자동실행(systemd, enable+active). 대시보드 `http://<젯슨IP>:8090`.
- **베이스(바퀴) = 실제 동작**: "앞으로 가"/"전진" → 1.5초 전진, "토마토" → 전진1초→프리셋→후진1초.
- **팔 = 실제 동작**: "팔 움직여"/"움직여" → 프리셋 1→2→3→4 재생. `USE_REAL_ARM=True`(repo와 일치).
- **음성 STT**: faster-whisper `base`, **CPU**(int8). 환각 게이트/정규화 튜닝 적용됨.
- **안정성**: 전원분리 후 uptime 11시간+ 재부팅 0 (베이스 주행 포함).

## 팔 복구 완료 기록 (2026-07-29, 같은 날 완료)

- 팔로워(ttyACM0)·리더(ttyACM1) 둘 다 연결, 모터 6개씩 스캔 OK.
- 팔로워 캘리(tomato_follower), **리더 캘리(tomato_leader) 재수행** 완료.
- **`arm_presets.json` 4슬롯 재교시 완료**(`tools/mirror_toggle.py` 미러링으로: `l`=미러ON, 1~4=저장). 슬롯1 집게벌림→2 쥐기→3,4 이동.
- `USE_REAL_ARM=True` 복원 + 서비스 재시작. **repo와 젯슨 config 일치 — 상태 불일치 해소됨.**
- 재배포 주의: presets는 `~/arm_presets.json`에만 있음(repo 밖). 재플래시 시 다시 교시 필요.

## 재설치 시 알아야 할 젯슨 환경 메모

- venv = `~/lerobot/.venv`. 설치: `lerobot==0.5.1`(PyPI에 0.5.2 없음), `feetech-servo-sdk`, `faster-whisper`,
  `pyserial`, `python-dotenv`, `numpy`. **torch 2.10.0+cpu**(이 데모는 전부 CPU, CUDA 불필요).
- **CH340 베이스 드라이버(ch341)가 JetPack7 커널에 없음** → out-of-tree 빌드해 설치함
  (`~/ch341build`, `/lib/modules/$(uname -r)/kernel/drivers/usb/serial/`에 설치 + depmod). 재플래시 시 재빌드 필요.
- `server`를 `dialout,audio,input,video` 그룹에 추가함.
- 장치: `/dev/ttyUSB0`=베이스(CH340), `/dev/ttyACM0`=팔(팔로워).

## 보류된 개선 (다음 논의)

- **"한번에 못 듣는" 인식률** — 속도(GPU)가 아니라 정확도 문제. ①VAD 임계값 재튜닝(새 마이크 기준, 빠른 해결)
  ②GPU로 큰 모델(medium/large) 돌리기(정확도 근본개선이나 이 젯슨 CUDA Whisper는 난도 높음).
