ttkpark/tomato-picker/docs/line-course/detect_check.jpg

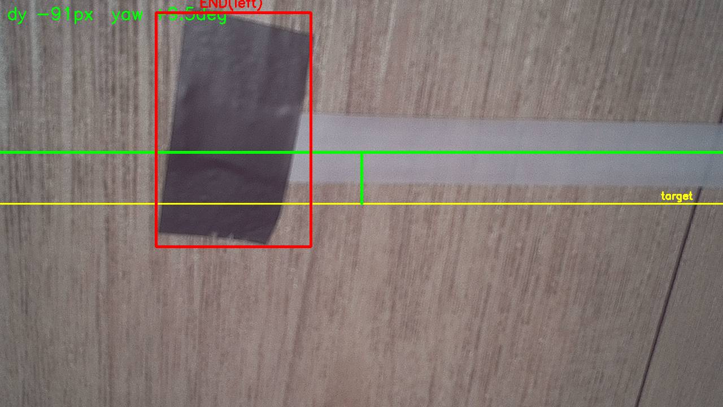
docs/line-course/detect_check.jpg
