ttkpark/tomato-picker/docs/line-course/floor_purple.jpg

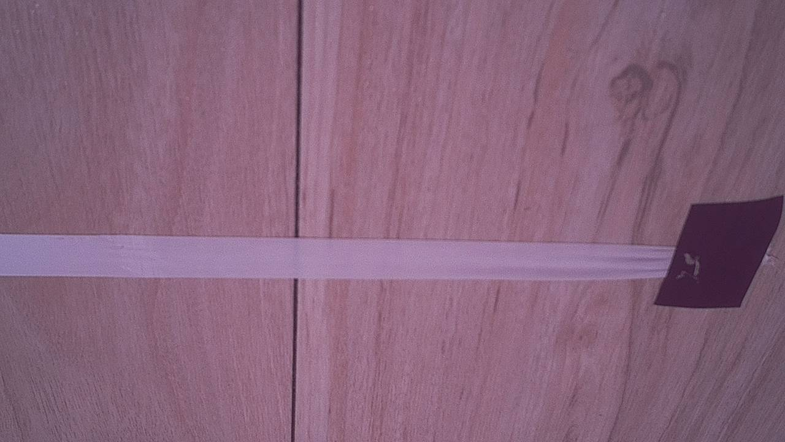
docs/line-course/floor_purple.jpg
