ttkpark/tomato-picker/docs/line-course/live_check.jpg

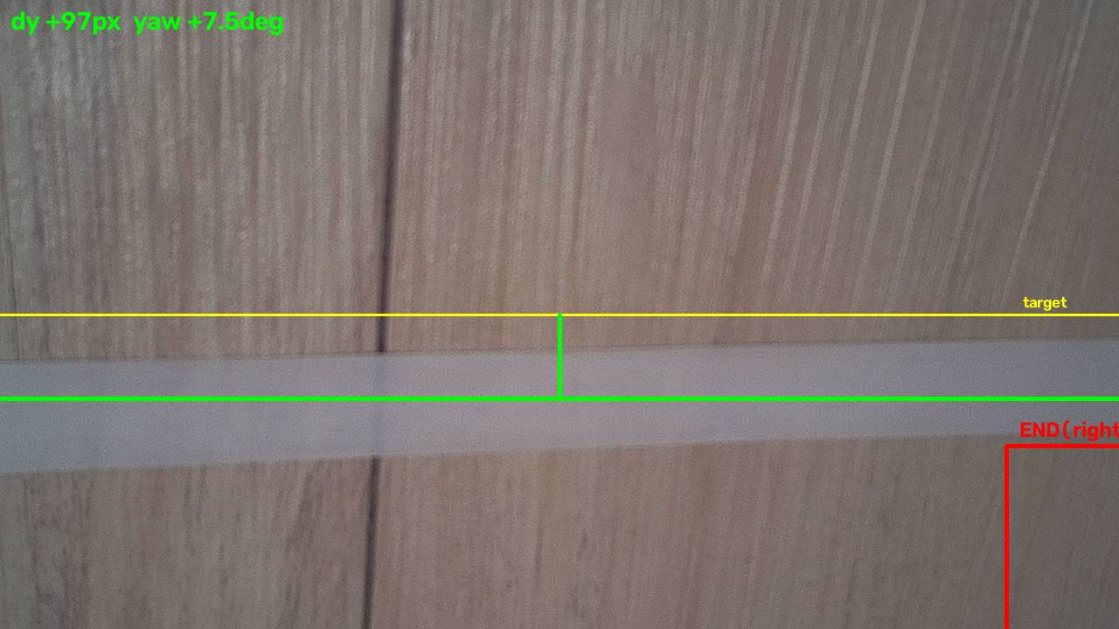
docs/line-course/live_check.jpg
