ttkpark/tomato-picker/docs/line-course/paper_check.jpg

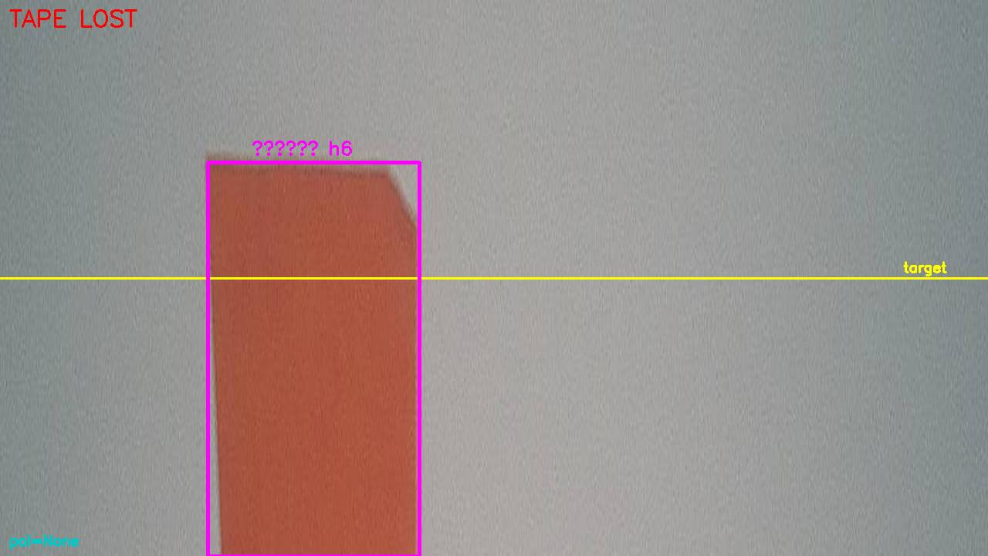
docs/line-course/paper_check.jpg
