ttkpark/tomato-picker/docs/line-course/stage_now.jpg

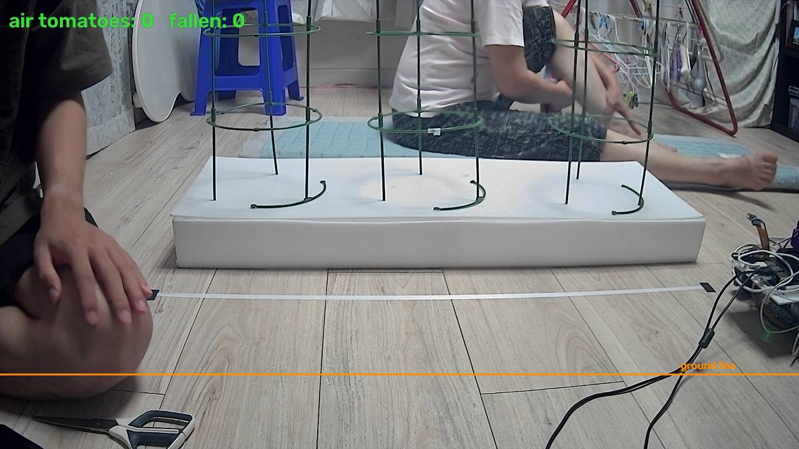
docs/line-course/stage_now.jpg
