ttkpark/tomato-picker/docs/line-course/station_check.jpg

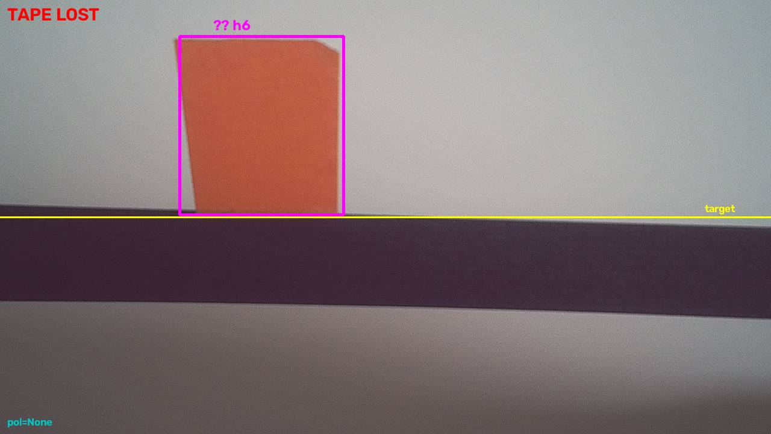
docs/line-course/station_check.jpg
