ttkpark/tomato-picker/3D/BOTTOM.stl

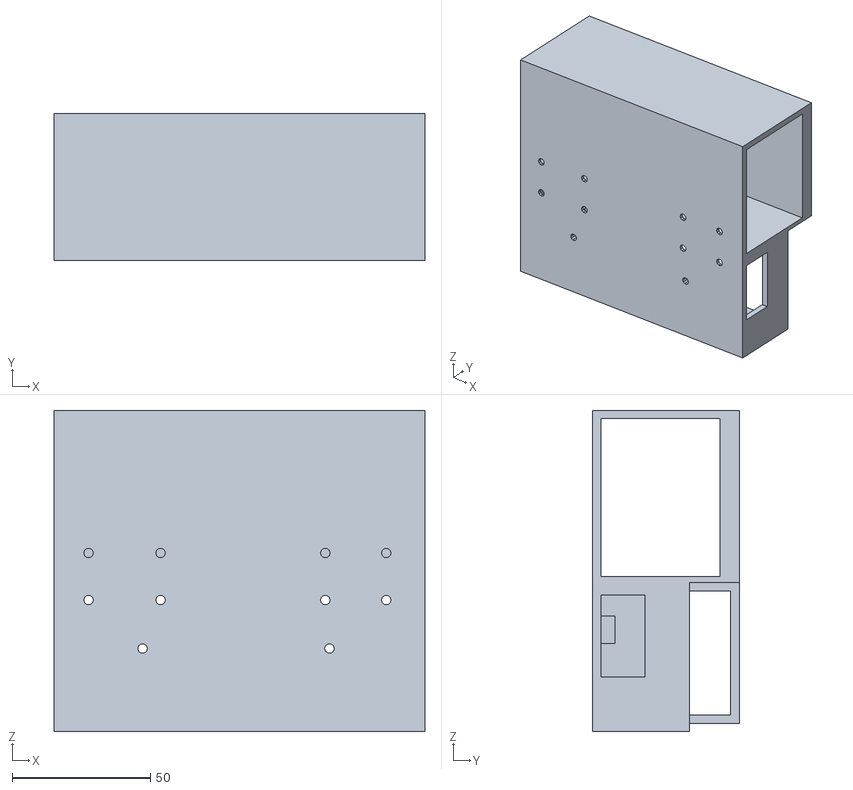
[picture p9: CAD file, 2026-08-17]
3D/BOTTOM.stl
134.0 x 53.0 x 116.0
