ttkpark/tomato-picker/3D/TOPRight.stl

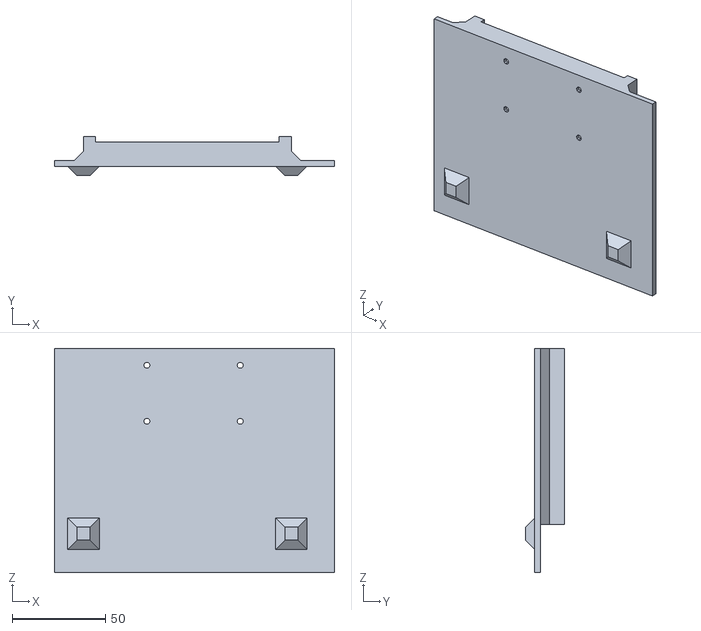
[picture p10: CAD file, 2026-08-06]
3D/TOPRight.stl
150.0 x 21.0 x 120.0
