ttkpark/tomato-picker/3D/TOPLeft.stl

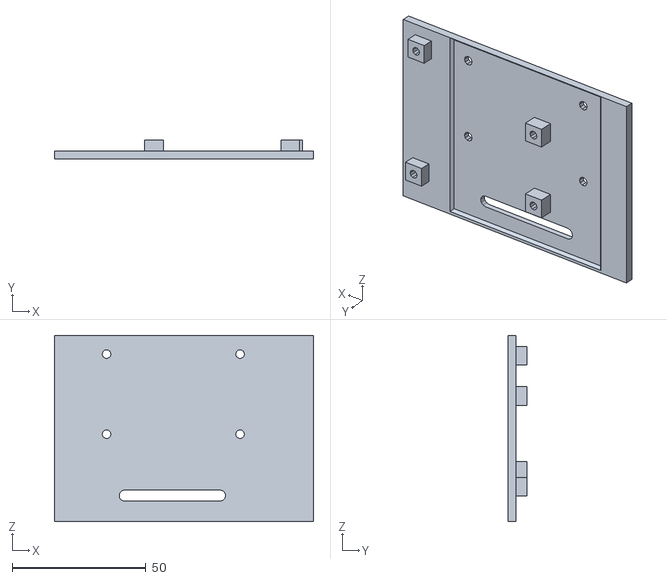
[picture p11: CAD file, 2026-08-06]
3D/TOPLeft.stl
97.0 x 7.00 x 69.8
