ttkpark/tomato-picker/(list of files, cad)

Other CAD files:
3D/BOTTOM.ipt
3D/OldVersions/BOTTOM.0003.ipt
3D/OldVersions/TOPLeft.0002.ipt
3D/OldVersions/TOPRight.0002.ipt
3D/TOPLeft.ipt
3D/TOPRight.ipt
