ttkpark/tomato-picker/firmware/PS2-MOTOR/PS2-MOTOR.ino

#include <PS2X_lib.h>  //for MOEBIUS
#include "FaBoPWM_PCA9685.h"

//#include "servo.hpp"

FaBoPWM faboPWM;
int pos = 0;
int MAX_VALUE = 2000;   // 电机速度限制 motor speed
int MIN_VALUE = 300;

//PS2手柄引脚；PS2 handle Pin
#define PS2_DAT        13
#define PS2_CMD        11
#define PS2_SEL        10
#define PS2_CLK        12

//MOTOR CONTROL Pin
#define DIRA1 0
#define DIRA2 1
#define DIRB1 2
#define DIRB2 3
#define DIRC1 4
#define DIRC2 5
#define DIRD1 6
#define DIRD2 7

char speed;
#define pressures   false
#define rumble      false

PS2X ps2x; // create PS2 Controller Class

int error = 0;
byte type = 0;
byte vibrate = 0;

void (* resetFunc) (void) = 0;

//电机控制，前进、后退、停止   motor control advance\back\stop
#define MOTORA_FORWARD(pwm)    do{faboPWM.set_channel_value(DIRA1,pwm);faboPWM.set_channel_value(DIRA2, 0);}while(0)
#define MOTORA_STOP(x)         do{faboPWM.set_channel_value(DIRA1,0);faboPWM.set_channel_value(DIRA2, 0);}while(0)
#define MOTORA_BACKOFF(pwm)    do{faboPWM.set_channel_value(DIRA1,0);faboPWM.set_channel_value(DIRA2, pwm);}while(0)

#define MOTORB_FORWARD(pwm)    do{faboPWM.set_channel_value(DIRB1,pwm);faboPWM.set_channel_value(DIRB2, 0);}while(0)
#define MOTORB_STOP(x)         do{faboPWM.set_channel_value(DIRB1,0);faboPWM.set_channel_value(DIRB2, 0);}while(0)
#define MOTORB_BACKOFF(pwm)    do{faboPWM.set_channel_value(DIRB1,0);faboPWM.set_channel_value(DIRB2, pwm);}while(0)

#define MOTORC_FORWARD(pwm)    do{faboPWM.set_channel_value(DIRC1,pwm);faboPWM.set_channel_value(DIRC2, 0);}while(0)
#define MOTORC_STOP(x)         do{faboPWM.set_channel_value(DIRC1,0);faboPWM.set_channel_value(DIRC2, 0);}while(0)
#define MOTORC_BACKOFF(pwm)    do{faboPWM.set_channel_value(DIRC1,0);faboPWM.set_channel_value(DIRC2, pwm);}while(0)

#define MOTORD_FORWARD(pwm)    do{faboPWM.set_channel_value(DIRD1,pwm);faboPWM.set_channel_value(DIRD2, 0);}while(0)
#define MOTORD_STOP(x)         do{faboPWM.set_channel_value(DIRD1,0);faboPWM.set_channel_value(DIRD2, 0);}while(0)
#define MOTORD_BACKOFF(pwm)    do{faboPWM.set_channel_value(DIRD1,0);faboPWM.set_channel_value(DIRD2, pwm);}while(0)

#define MAX_PWM   2000
#define MIN_PWM   300

int Motor_PWM = 2000;  // 속도 100% (최대 스케일 2000 기준). 전력 측정용 — brownout 가능성 주의.

//    ↑A-----B↑
//     |  ↑  |
//    ↑C-----D↑
void ADVANCE(uint8_t pwm_A,uint8_t pwm_B,uint8_t pwm_C,uint8_t pwm_D)
{
  MOTORA_BACKOFF(Motor_PWM);MOTORB_FORWARD(Motor_PWM);
  MOTORC_BACKOFF(Motor_PWM);MOTORD_FORWARD(Motor_PWM);
}
void BACK()
{
  MOTORA_FORWARD(Motor_PWM);MOTORB_BACKOFF(Motor_PWM);
  MOTORC_FORWARD(Motor_PWM);MOTORD_BACKOFF(Motor_PWM);
}
void LEFT_1()
{
  MOTORA_STOP(Motor_PWM);MOTORB_FORWARD(Motor_PWM);
  MOTORC_BACKOFF(Motor_PWM);MOTORD_STOP(Motor_PWM);
}
void LEFT_2()
{
  MOTORA_FORWARD(Motor_PWM);MOTORB_FORWARD(Motor_PWM);
  MOTORC_BACKOFF(Motor_PWM);MOTORD_BACKOFF(Motor_PWM);
}
void LEFT_3()
{
  MOTORA_FORWARD(Motor_PWM);MOTORB_STOP(Motor_PWM);
  MOTORC_STOP(Motor_PWM);MOTORD_BACKOFF(Motor_PWM);
}
void RIGHT_1()
{
  MOTORA_BACKOFF(Motor_PWM);MOTORB_STOP(Motor_PWM);
  MOTORC_STOP(Motor_PWM);MOTORD_FORWARD(Motor_PWM);
}
void RIGHT_2()
{
  MOTORA_BACKOFF(Motor_PWM);MOTORB_BACKOFF(Motor_PWM);
  MOTORC_FORWARD(Motor_PWM);MOTORD_FORWARD(Motor_PWM);
}
void RIGHT_3()
{
  MOTORA_STOP(Motor_PWM);MOTORB_BACKOFF(Motor_PWM);
  MOTORC_FORWARD(Motor_PWM);MOTORD_STOP(Motor_PWM);
}
void rotate_1()
{
  MOTORA_BACKOFF(Motor_PWM);MOTORB_BACKOFF(Motor_PWM);
  MOTORC_BACKOFF(Motor_PWM);MOTORD_BACKOFF(Motor_PWM);
}
void rotate_2()
{
  MOTORA_FORWARD(Motor_PWM);MOTORB_FORWARD(Motor_PWM);
  MOTORC_FORWARD(Motor_PWM);MOTORD_FORWARD(Motor_PWM);
}
void STOP()
{
  MOTORA_STOP(Motor_PWM);MOTORB_STOP(Motor_PWM);
  MOTORC_STOP(Motor_PWM);MOTORD_STOP(Motor_PWM);
}

void IO_init()
{
  STOP();
}

void setup()
{
  IO_init();
  Serial.begin(115200);   // 젯슨 mirror_toggle.py(115200)와 맞춤
  if(faboPWM.begin())
  {
    Serial.println("Find PCA9685");
    faboPWM.init(300);
  }
  faboPWM.set_hz(50);
  Serial.print("Start");

  delay(300); // 무선 PS2 모듈 기동 대기
  error = ps2x.config_gamepad(PS2_CLK, PS2_CMD, PS2_SEL, PS2_DAT, pressures, rumble);

  if (error == 0) {
    Serial.println("Found Controller, configured successful");
  }
  else if (error == 1) {
    Serial.println("No controller found (will retry, no reboot)");
    // resetFunc() 제거: 노이즈로 한 번 실패해도 재부팅하지 않고 loop에서 재시도한다.
  }
  else if (error == 2)
    Serial.println("Controller found but not accepting commands");
  else if (error == 3)
    Serial.println("Controller refusing to enter Pressures mode");

  type = ps2x.readType();
  Serial.print("Controller_type: "); Serial.println(type);
}

// 손상프레임 판정용 전체 버튼 목록 (핀13 노이즈 대응)
const uint16_t ALLB[] = {
  PSB_PAD_UP, PSB_PAD_DOWN, PSB_PAD_LEFT, PSB_PAD_RIGHT,
  PSB_PINK, PSB_RED, PSB_BLUE, PSB_GREEN, PSB_START, PSB_SELECT,
  PSB_L1, PSB_L2, PSB_R1, PSB_R2, PSB_L3, PSB_R3
};

void loop()
{
  // 아직 컨트롤러 미인식이면 재부팅 없이 조용히 재시도(노이즈로 한 번 실패해도 버팀).
  if (error != 0) {
    STOP();                 // 미인식 상태에선 모터 정지 보장
    error = ps2x.config_gamepad(PS2_CLK, PS2_CMD, PS2_SEL, PS2_DAT, pressures, rumble);
    if (error == 0) type = ps2x.readType();
    delay(50);
    return;
  }
  if (type == 2) return;        // Guitar Hero 무시

  ps2x.read_gamepad(false, vibrate);

  // 손상프레임 가드(핀13 DAT 노이즈): 버튼이 7개 이상 동시에 눌림으로 나오면 손상 프레임 → 스킵.
  // 주의: 아날로그 4축이 모두 255/0인지로 판정하면 안 된다 — 컨트롤러가 "디지털 모드"
  // (아날로그 LED 꺼짐)일 땐 정상 상태에서도 4축이 항상 0xFF(255)라서 매 프레임이
  // 오탐되어 버튼 입력이 전혀 처리되지 않는다(ps2_toggle.ino에서 확인된 이슈).
  uint8_t nb = 0;
  for (uint8_t i = 0; i < 16; i++) if (ps2x.Button(ALLB[i])) nb++;
  static uint8_t corruptStreak = 0;
  if (nb >= 7) {
    // 손상 프레임이 잠깐이면 마지막 상태 유지(단발 노이즈 무시), 하지만
    // 연속으로 계속되면(신호 끊김 등) 마지막 명령이 영원히 래치되어 폭주할 수 있으므로
    // 안전하게 강제 정지한다.
    if (++corruptStreak >= 5) STOP();
    delay(20);
    return;
  }
  corruptStreak = 0;

  // L1 -> 젯슨 미러링 토글: 뗐다 다시 누르는 순간 1회 "TOGGLE" 전송.
  // (mirror_toggle.py가 받아 리더->팔로워 미러링 ON/OFF. L1은 주행에 안 쓰임.)
  static bool l1armed = true;
  static unsigned long lastTog = 0;
  if (ps2x.Button(PSB_L1)) {
    if (l1armed && millis() - lastTog > 300) {   // 300ms 리프랙토리: 노이즈 중복발사 방지
      Serial.println("TOGGLE");
      l1armed = false;
      lastTog = millis();
    }
  } else {
    l1armed = true;
  }

  // R1 + 면버튼(△○✕□) => 프리셋 1~4 명령(엣지). 젯슨이 미러링 상태에 따라 저장/재생.
  bool r1 = ps2x.Button(PSB_R1);
  const uint16_t FACE[4] = {PSB_TRIANGLE, PSB_CIRCLE, PSB_CROSS, PSB_SQUARE};
  static bool presetArmed[4] = {true, true, true, true};
  for (uint8_t i = 0; i < 4; i++) {
    bool face = ps2x.Button(FACE[i]);
    if (r1 && face && presetArmed[i]) {
      Serial.print("PRESET "); Serial.println(i + 1);   // 1=△ 2=○ 3=✕ 4=□
      presetArmed[i] = false;
    }
    if (!face) presetArmed[i] = true;   // 면버튼 떼면 재무장
  }

  // 누르고 있는 동안만 이동. (R1 누른 중엔 □○ 평행이동 무시 — 프리셋 모디파이어 우선)
  bool moving = true;
  if      (ps2x.Button(PSB_PAD_UP)   || ps2x.Button(PSB_START)) ADVANCE(500,500,500,500);
  else if (ps2x.Button(PSB_PAD_DOWN))    BACK();
  else if (ps2x.Button(PSB_PAD_LEFT))    rotate_2();   // 좌회전
  else if (ps2x.Button(PSB_PAD_RIGHT))   rotate_1();   // 우회전
  else if (!r1 && ps2x.Button(PSB_PINK)) LEFT_2();     // □ 좌평행(strafe)
  else if (!r1 && ps2x.Button(PSB_RED))  RIGHT_2();    // ○ 우평행(strafe)
  else moving = false;

  // 뗌 디바운스: 깨끗한 프레임에서 2회 연속 '아무 방향키도 안 눌림'일 때만 정지
  // → 손상 프레임 하나로 인한 순간 끊김 방지.
  static uint8_t noBtn = 0;
  if (moving) noBtn = 0;
  else if (++noBtn >= 2) STOP();
  delay(20);
}
