ttkpark/tomato-picker/tools/arm_cartesian_check.py

#!/usr/bin/env python3
"""카테시안 유닛 자체검증 — **팔도 젯슨도 없이** 개발 PC에서 돈다.

    python tools/arm_cartesian_check.py

무엇을 확인하나:
  ① FK → IK → FK 왕복이 제자리로 돌아오는가 (기구학이 맞는가)
  ② 조그가 **요청한 만큼, 요청한 방향으로** 끝점을 옮기는가
  ③ 제자리 회전이 **정말 제자리인가** (끝점이 안 움직이는가)
  ④ 안전 검사가 실제로 막는가 (너무 작다/너무 크다/사거리 밖/바닥 아래/영점 없음)
  ⑤ 교시 자세(곧게 세운 팔)를 영점으로 잡으면 각도와 좌표가 맞게 나오는가

왜 이걸 만들었나 — 좌표 이동의 버그는 "팔이 엉뚱한 데로 간다"로 나타나고,
그건 부러진 집게로 배우게 된다. 여기서 걸리는 종류의 실수(부호, 라디안/도,
왕복 불일치)는 실물에서 확인할 이유가 없다.
"""

from __future__ import annotations

import math
import os
import random
import sys
import tempfile

# 윈도우 콘솔(cp949)에서도 한글/기호가 안 깨지게 — main.py와 같은 처리.
# (이 도구의 존재 이유가 "개발 PC에서 돈다"인데, 출력의 em dash 하나에
#  UnicodeEncodeError로 죽으면 검증 자체를 못 한다.)
for _stream in (sys.stdout, sys.stderr):
    if hasattr(_stream, "reconfigure"):
        _stream.reconfigure(encoding="utf-8")

sys.path.insert(0, os.path.join(os.path.dirname(os.path.abspath(__file__)), "..", "src"))

from tomato_picker.hardware import kinematics as kin  # noqa: E402
from tomato_picker.hardware.cartesian import CartesianArm, SimJointIO  # noqa: E402
from tomato_picker.hardware.kinematics import ArmGeometry  # noqa: E402
from tomato_picker.config import ARM_CART_ZERO_POSE_DEG as ZERO_POSE  # noqa: E402

FAILED: list[str] = []
PASSED = 0


def check(name: str, ok: bool, detail: str = "") -> None:
    global PASSED
    if ok:
        PASSED += 1
        print(f"  ok   {name}" + (f"  ({detail})" if detail else ""))
    else:
        FAILED.append(name)
        print(f"  FAIL {name}  {detail}")


def expect_error(name: str, fn, must_contain: str = "") -> None:
    try:
        fn()
    except Exception as exc:  # noqa: BLE001 - 막혔는지가 관심사
        text = str(exc)
        check(name, must_contain in text, f"거절함: {text[:70]}")
        return
    check(name, False, "막았어야 하는데 통과했다")


# ----------------------------------------------------------------------

def test_roundtrip(geom: ArmGeometry) -> None:
    print("\n① 기구학 왕복 (FK → IK → FK)")
    random.seed(7)
    worst = 0.0
    tried = skipped = 0
    for _ in range(20000):
        j = {
            "shoulder_pan": random.uniform(-100, 100),
            "shoulder_lift": random.uniform(-20, 90),
            "elbow_flex": random.uniform(-150, -10),
            "wrist_flex": random.uniform(-100, 60),
            "wrist_roll": random.uniform(-180, 180),
        }
        pose = kin.forward(j, geom)
        if kin.signed_radius(j, geom) < 30:   # 몸통 뒤로 접힌 자세는 좌표가 모호하다
            skipped += 1
            continue
        tried += 1
        back = kin.inverse(pose, geom, seed_pan=j["shoulder_pan"])
        again = kin.forward(back, geom)
        worst = max(worst, abs(pose.x - again.x), abs(pose.y - again.y),
                    abs(pose.z - again.z), abs(pose.pitch - again.pitch))
        for name in kin.ARM_JOINTS:            # 관절값 자체도 돌아와야 한다
            worst = max(worst, abs(kin.wrap180(back[name] - j[name])))
    check("무작위 20000자세 왕복 오차 < 1e-6", worst < 1e-6,
          f"최대 {worst:.2e} · {tried}개 검사 · 접힌자세 {skipped}개 제외")


def test_jog() -> None:
    print("\n② 조그 — 요청한 방향으로 요청한 만큼")
    arm = fresh_arm()
    start = arm.pose()
    for axis, dx, dy, dz in (("x", 20, 0, 0), ("y", 0, 25, 0), ("z", 0, 0, 30),
                             ("-z", 0, 0, -15)):
        before = arm.pose()
        arm.jog(dx=dx, dy=dy, dz=dz)
        after = arm.pose()
        got = (after.x - before.x, after.y - before.y, after.z - before.z)
        err = max(abs(got[0] - dx), abs(got[1] - dy), abs(got[2] - dz))
        check(f"base {axis} {dx or dy or dz:+g}mm", err < 1e-6,
              f"실제 Δ=({got[0]:+.3f}, {got[1]:+.3f}, {got[2]:+.3f})")
    check("pitch는 조그로 안 변한다", abs(arm.pose().pitch - start.pitch) < 1e-9)

    print("\n   도구 좌표계 — 집게가 보는 쪽으로 전진")
    arm = fresh_arm()
    # ⚠ 2026-08-31 실측으로 l3가 95 → 168mm가 되면서 이 각이 -30°면 손목이
    #    사거리를 넘는다(팔이 커지면 같은 각도라도 손목이 훨씬 뒤로 물러난다).
    #    시험의 뜻(집게가 보는 쪽으로 전진)은 그대로고 크기만 줄인다.
    arm.jog(dpitch=-15)                      # 집게를 15° 더 숙인다
    before = arm.pose()
    arm.jog(dx=20, frame="tool")             # 보는 쪽으로 20mm
    after = arm.pose()
    d = (after.x - before.x, after.y - before.y, after.z - before.z)
    ph = math.radians(before.pitch)
    want = (20 * math.cos(ph), 0.0, 20 * math.sin(ph))
    check(f"tool 전진 20mm (pitch {before.pitch:.0f}°) = 수평{want[0]:.1f} / 수직{want[2]:+.1f}",
          max(abs(d[i] - want[i]) for i in range(3)) < 1e-6,
          f"Δ=({d[0]:+.2f}, {d[1]:+.2f}, {d[2]:+.2f})")
    check("전진해도 집게 각은 그대로", abs(after.pitch - before.pitch) < 1e-9)
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
