ttkpark/tomato-picker/(commit log)

2026-06-27 Initial commit: tomato-picker demo + 실장비(메카넘 베이스 · SO-101 팔) 브링업
    소프트웨어(데모):
    - Claude tool-use 오케스트레이션 + 오프라인 데모, 스킬 함수 5종, HSV 색검출, Mock 하드웨어
    실장비 제어:
    - firmware/PS2-MOTOR: Moebius 메카넘 PS2 주행 + L1 팔 미러링 토글 + R1 모션 프리셋(1~4).
    핀13 노이즈 필터, 워치독(0.25s 폭주컷), 누름=이동/뗌=정지, 속도 30%
    - tools/mirror_toggle.py: SO-101 리더→팔로워 미러링 + 모션 프리셋 저장/재생(영속).
    토마토 따기 = 프리셋 1→2→3→4 순차 재생
    문서:
    - README에 하드웨어 제어 섹션, firmware/README.md 추가
    Co-Authored-B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
2026-07-02 firmware(PS2-MOTOR): 속도 100%로 올리고 손상프레임 판정 버그 수정
    - Motor_PWM 600(30%) -> 2000(100%): 전력 측정 목적.
    - 워치독(250ms) 제거: loop() 정상 실행 중에도 오리셋되어 주행이
    반복 재부팅되던 문제. 대신 손상 프레임 5연속 시 소프트웨어
    STOP()으로 폭주(래치된 마지막 PWM 유지) 방지.
    - 손상프레임 판정에서 "아날로그 4축 전부 255/0" 조건 제거: 컨트롤러가
    디지털 모드일 때 항상 255라 매 프레임이 오탐되어 버튼 입력이 전혀
    처리되지 않던 버그(ps2_toggle.ino 진단에서 확인된 것과 동일 원인).
    [PS2-MOTOR.ino]
2026-07-02 firmware: 이번 브링업 세션 지식 문서화 + 진단 스케치 커밋
    다른 컴퓨터에서 이어서 작업할 수 있도록 젯슨 실기에서만 존재하던
    진단 스케치와 이번에 확인한 사실들을 저장소에 반영.
    - firmware/diagnostics/에 ps2_probe, ps2_toggle, ps2_stream, ps2_diag,
    boot_probe 추가. PS2 핀맵 확정, 디지털모드 오탐 버그 확인, PCA9685
    I2C hang 위치 특정에 각각 쓰였던 것들.
    - firmware/README.md 업데이트: 확정 PS2 핀맵, ttyUSB0/ttyACM0 포트
    매핑, 워치독 제거+소프트웨어 STOP 방어로 바뀐 경위, PCA9685 I2C
    타임아웃 부재로 인한 무한 hang 주의사항, 원격 젯슨 접속 메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
2026-07-07 hardware: 베이스 전면 카메라(MJPG)·SO-101 프리셋 팔 실물 구현 추가
    USE_REAL_CAMERA/USE_REAL_ARM 플래그로 build_robot()이 Mock 대신
    JetsonCamera/LerobotArm을 조립하도록 확장. 프리셋 1-4 시퀀스를
    pick/place로 나누는 매핑은 config.py에서 조정 가능.
2026-07-07 voice: 온디바이스 음성 명령("팔 움직여") + 실시간 인식 로그(SSE) 추가
    마이크(arecord)→RMS 기반 VAD→faster-whisper(ko, CPU/int8)→키워드 인텐트
    매칭까지 잇는 파이프라인. 인식 결과는 stdlib http.server SSE로 스트리밍해
    브라우저(http://<젯슨IP>:8090)에서 실시간 확인 가능. RobotArm 인터페이스에
    demo_move() 추가(음성 트리거용 전체 프리셋 시퀀스 재생).
2026-07-08 voice: 마이크 카드 자동탐지 + USB I/O 오류 시 자동 재연결
    실측 결과 카메라 마이크의 ALSA 카드 번호가 재부팅/재연결마다 바뀌고
    (card 2 → card 0), USB 오디오 코덱 클럭 불안정으로 arecord가 이따금
    "Input/output error"로 죽는 걸 확인. 카드 번호 하드코딩 대신 이름으로
    찾고, 마이크가 끊기면 서비스가 조용히 멈추는 대신 재연결을 반복하며
    실시간 로그로 알리도록 수정.
2026-07-08 voice: plughw 리샘플 버그 우회 — raw hw로 48kHz 캡처 후 직접 다운샘플
    실측 결과 이 카메라(Alcorlink 코덱)를 plughw로 열면 완전 무음이 잡힘
    (dmesg: current rate 33186 != runtime rate 48000 — 커널이 클럭 불일치를
    감지하고 ALSA plug 리샘플러가 깨지는 것으로 보임). Windows에서는 같은
    마이크가 정상 동작해 하드웨어 결함은 아님. hw(raw)로 열어 48kHz 그대로
    받고 파이썬에서 3:1 박스필터로 16kHz 다운샘플하니 실제 음성이 잡힘.
2026-07-08 voice: STT 입력 피크 정규화 — 평소 톤도 인식되게
    실기 테스트 결과 이 마이크는 평소 목소리로는 대부분 인식 실패하고
    크게 외쳐야만 인식됨(2026-07-08, "팔 움직여" 성공 확인은 큰 소리에서만).
    Whisper에 넣기 전 오디오 피크를 목표치까지 증폭해 보통 톤도 인식되게 함.
    거의 무음인 구간은 잡음만 커지므로 증폭하지 않음.
2026-07-08 voice: 마이크를 웹캠으로 교체 — 카드 자동탐지를 이름매칭 대신 APE 제외 방식으로, VAD 임계값 재조정
    기존 카메라(2ce5:c672)를 웹캠(1d5b:0104)으로 교체. 카드 이름이
    "Camera"→"webcam"으로 바뀌어 이름 하드코딩이 다시 깨지므로, 젯슨
    내장 오디오(APE)가 아닌 첫 카드를 쓰는 방식으로 일반화. 이 웹캠은
    16kHz 네이티브 지원 확인(다운샘플 불필요, factor=1)하고 plughw로도
    클럭 버그 없이 정상 동작하나 hw 경로는 그대로 유지(다음 마이크 교체
    대비 안전한 공통 경로). 바닥 노이즈가 기존 마이크(~120)보다 훨씬
    높아(~1500~1800) VAD_RMS_THRESHOLD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
2026-07-08 voice: 인텐트 키워드에서 "팔" 필수 요건 완화
    실기 테스트 결과 "팔"이 STT에서 "파는"/"잘" 등으로 자주 오인식됨
    (2026-07-08). "움직여" 계열 단독으로도 arm_move 인텐트가 매칭되게 넓힘.
2026-07-08 voice: VAD에 pre-roll 추가 — 파열음 초성("팔" 등) 잘림 방지
    발화 시작 트리거 직전 0.2초를 항상 버퍼링해뒀다가 발화 시작 시 앞에
    붙임. "팔"이 "파는"/"잘"/"타는" 등으로 자주 오인식되는 게 VAD가 트리거된
    순간 이미 파열음 어택이 지나가 있어서일 가능성이 있어 시도.
2026-07-08 config: 음성 명령으로 실물 팔 동작 활성화(USE_REAL_ARM=True)
    controller-drive.service가 같은 ttyACM0 포트를 잡고 있어 충돌 —
    젯슨에서 서비스 정지 후(sudo systemctl stop) 적용.
2026-07-08 feat: 젯슨 게임패드 주행 + 팔 프리셋 통합 (mecanum_stable 펌웨어 + 드라이버 + 서비스)
    다른 환경에서도 통합할 수 있도록 이번 브링업 산출물을 저장소에 반영.
    - firmware/mecanum_stable/: 젯슨 시리얼 주행용 안정 펌웨어(PS2 배제). V/S/T/P/L 프로토콜,
    데드맨(400ms)+HW워치독(WDTO_250MS), 실측 모터매핑 A=FR/B=FL/C=RR/D=RL, POL={-1,1,-1,1}.
    - tools/controller_drive.py: Switch 프로콘/Xbox360 양쪽 지원 evdev 드라이버. LT(ZL) 데드맨,
    왼스틱=이동/오른스틱=회전/D패드=디지털, LB/RB=팔 프리셋 재생(리더 없이 팔로워만),
    모터 시리얼 자동재연결(CH340 끊김 자가복구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
2026-07-08 docs: 현재 하드웨어 구성(mecanum_stable/게임패드 드라이버) 문서화 + CLAUDE.md 추가
    다른 에이전트가 옛 문서(PS2-MOTOR=현재)로 오해하지 않도록 메인 문서 갱신.
    - CLAUDE.md 신규: 에이전트 오리엔테이션 — 현재 주행펌웨어=mecanum_stable(시리얼 V/S),
    게임패드 드라이버=tools/controller_drive.py(systemd 자동실행), 젯슨 접속·알려진 함정.
    - README.md/firmware/README.md: mecanum_stable을 현재 사용으로, PS2-MOTOR=레거시로 재분류.
2026-07-08 voice+base: "앞으로 가" 음성 명령으로 실제 전진 + JetsonBase 프로토콜 수정
    베이스 실물 펌웨어가 firmware/mecanum_stable/mecanum_stable.ino(PS2 제거,
    PCA9685 기반 V/S 속도 프로토콜)로 바뀐 걸 확인. 기존 JetsonBase는 이 보드가
    쓴 적 없는 mecanum_serial.ino의 G-ticks 프로토콜을 가정하고 있었고
    BASE_SERIAL_PORT도 팔 포트(ttyACM0)로 잘못 설정돼 있어 둘 다 수정
    (베이스는 ttyUSB0). MobileBase에 drive_forward(seconds) 추가 — 이 펌웨어가
    엔코더 피드백이 없는 오픈루프라 거리 기반 drive_to는 아직 캘리브레이션
    전이므로 NotImplementedError로 명시. voice_mode에 base 조립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
    [base.py, jetson.py, mock.py]
2026-07-08 config: 음성 베이스 전진 실물 활성화(USE_REAL_BASE=True, 바퀴 띄운 상태 테스트)
2026-07-08 config: 베이스 전진 속도 상향(150→220), 실기 확인 후
2026-07-08 voice: "토마토" 명령 — 전진(1s)→팔 프리셋→후진(1s) 시퀀스 추가
    비전 기반 위치 추정 전 임시 버전: 토마토 위치까지 하드코딩된 시간만큼
    전진, 프리셋(1→2→3→4) 재생으로 수확 동작, 하드코딩된 시간만큼 후진해
    대기 위치로 복귀. MobileBase에 drive_backward(seconds) 추가.
2026-07-08 voice: 인텐트 실행을 큐+워커스레드 하나로 직렬화
    인식마다 새 스레드를 띄우던 방식은 "토마토"와 "앞으로 가"가 몇 초 안에
    겹쳐 인식되면 두 스레드가 동시에 같은 시리얼 포트(베이스)에 써서 명령이
    깨지는 문제가 있었음(2026-07-08 실측 — 예외 없이 조용히 무시되는
    바퀴 안 움직임으로 나타남). 워커 스레드 하나가 큐에서 인텐트를 순차
    처리하도록 바꿔 하드웨어 명령이 절대 겹치지 않게 함. 마이크 읽기는
    여전히 안 막힘(큐 put은 논블로킹). 워커 예외도 이제 SSE 로그로 보임.
2026-07-08 fix(base): 베이스 연결을 매 주행 호출마다 새로 열도록 변경
    실기 테스트에서 서비스 시작 시 한 번 연결해 재사용하는 방식은 명령
    응답("ok V ...")은 정상인데 바퀴가 실제로 안 움직이는 현상이 재현됨
    (2026-07-08). 반면 독립 스크립트로 매번 새 연결(DTR 리셋 포함)을 열면
    여러 차례 반복해도 한 번도 실패하지 않았음 — CH340 장시간 연결
    안정성 이슈로 추정. drive_forward/drive_backward가 호출마다 새로
    연결·해제하도록 바꿔 검증된 패턴을 그대로 씀(호출당 ~2초 추가 걸림).
    [jetson.py]
2026-07-08 safety: 베이스 주행 속도 220→100(약39%)으로 하향
    강하게 전진 시 전압 출렁임으로 젯슨 팬이 순간 멎는 브라운아웃 징후
    관측됨(2026-07-08). 최악의 경우 아두이노 행/PWM래치 폭주 위험이 있어
    사용자 요청대로 40% 이하로 낮춤.
2026-07-08 safety: 베이스 주행 속도 100→60(약24%)으로 재하향
    100(39%)에서도 젯슨 전체가 리셋되는 브라운아웃 발생(2026-07-08) —
    속도 문제라기보다 배터리/전원 공급 한계로 보임. 사용자 요청으로
    더 낮췄으나 근본 해결 아님(배터리 충전/커넥터 점검 필요).
2026-07-21 voice: STT를 base 모델로 올리고 temperature fallback 비활성화
    실측(젯슨 CPU int8, 2026-07-21):
    - 기존 '~8초 지연'의 원인은 모델 크기가 아니라 faster-whisper의
    temperature fallback 재시도(애매한 오디오에서 3~12초로 튐).
    끄면 같은 오디오가 일관되게 ~1초.
    - 정확도: 실녹음 '팔 움직여'를 tiny='파울 문지겨'(매칭 실패),
    base='팔 움직여' 완벽 인식. base 추론 ~1.2초로 지연 페널티 미미.
2026-07-21 voice: 노이즈 환각 제거 — MIN_PEAK 0.15 상향 + no_speech 게이트 복원
    실측 튜닝(젯슨, 2026-07-21). 라이브에서 조용한 구간이 VAD를 통과하면
    정규화가 노이즈(peak 0.061)를 16배 증폭 → Whisper가 '이 영상은'/'ㄷㄷㄷ'
    환각을 내던 문제.
    - WHISPER_NORMALIZE_MIN_PEAK 0.02 -> 0.15: 바닥 노이즈 peak(0.061)와
    VAD 통과 발화 peak(>0.3) 사이. 노이즈는 증폭 안 하고 발화만 증폭.
    - stt.py: no_speech_threshold=None 제거(라이브러리 기본 복원). 이 게이트가
    무음/노이즈 환각을 걸러줌. temperature=0.0이 지연을 잡으므로 게이트를
    켜도 발화 지연 영향 없음.
    검증(배포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
2026-07-21 deploy: 부팅 자동실행 음성 서비스(tomato-voice) 추가
    젯슨 부팅 시 'python main.py voice'를 systemd로 자동 기동 — 팔+베이스를
    음성 명령으로 제어. audio/dialout 그룹, cwd=레포루트, Restart=always로
    하드웨어 미부착 시 재시도.
    controller-drive(게임패드 주행)와는 팔·베이스 시리얼 포트가 겹쳐 공존
    불가라, 젯슨에서 controller-drive는 disable하고 tomato-voice로 교체함
    (같은 조치 반복 시: sudo systemctl disable --now controller-drive).
2026-07-21 voice: 수확 트리거 확장 — '토마토' 오인식 대응
    '토마토' 단독은 base 모델이 이 마이크로 디코딩 실패(2026-07-21 실측:
    잘 녹음돼도 no_speech 0.83, base/small 모두 실패). '수확'/'따줘' 계열과
    자연스러운 '토마토 따줘' 문구, 그리고 관찰된 특이 오인식(도루도/도리또/
    도마뚱 등)을 tomato_pick 키워드에 추가해 발동 확률을 높임.
2026-07-28 docs: 재플래시 복구 핸드오프(2026-07-29) — 현재 상태·주의·다음작업 정리
    JetPack7 재플래시 후 재설치 상태 기록. 핵심 혼선방지: repo는
    USE_REAL_ARM=True지만 젯슨 실기는 arm_presets.json 소실로 False(팔=mock).
    베이스+음성은 실제 동작, 전원분리로 브라운아웃 해결 확인.
2026-07-29 docs: 팔 복구 완료 반영 — USE_REAL_ARM=True, 프리셋 재교시 완료
    리더암 연결→리더 캘리→mirror_toggle로 arm_presets.json 4슬롯 재교시→
    USE_REAL_ARM=True 복원. repo와 젯슨 config 일치, 상태 불일치 해소.
    전원분리 후 uptime 11시간+ 재부팅0 장기 안정성 확인.
2026-07-29 vision: 대시보드에 카메라 영상 + 실시간 토마토 개수 표시
    - VisionStreamer: 카메라 프레임을 color_detect로 검출해 박스+개수 오버레이,
    최신 JPEG 보관, 개수 변화를 log_hub(SSE)로 발행
    - server.py: /video MJPEG 엔드포인트 + 대시보드 HTML에 영상·개수 배너 추가
    - voice_mode: USE_REAL_CAMERA면 카메라+스트리머 기동(실패해도 음성/주행 계속)
    - 개수는 익은(빨강) 열매 기준. 순수 HSV라 빨간 비토마토 물체는 오검출 가능
    (장면 정리 또는 HSV 튜닝/Claude 비전으로 개선 여지)
    검증(젯슨): /video MJPEG 스트리밍 OK, 개수 SSE 발행 OK, 오버레이 확인.
    Co-Authore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
2026-07-29 vision: GPU YOLO-World 온디바이스 토마토 인식 (색검출 대체)
    빨간 물체를 다 세던 색검출 대신, 진짜 토마토만 인식하도록 온디바이스 GPU
    YOLO 도입(사용자 요청). 클로드비전 안 씀 — 전부 젯슨 GPU.
    - tools/tomato_vision.py: 독립 프로세스(vision venv, CUDA torch+ultralytics).
    YOLO-World 오픈보캐뷸러리로 'tomato' 검출(별도 학습 불필요), 박스+개수
    주석 프레임과 개수를 /dev/shm에 원자적 기록. GPU ~일부 fps.
    - voice/shared_vision.py: SharedFrameSource — 음성 서비스가 /dev/shm를 읽어
    대시보드 /video·개수 공급(torch 불필요, ~/lerobot/.venv 그대로).
    - config: USE_SHAR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
2026-07-29 vision: 개수 로그 도배 제거 — 롤링 평활 + 배너만 갱신
    - tomato_vision: 검출이 프레임마다 0↔1 깜빡여 개수가 튀던 문제 →
    최근 N프레임(기본10) 최댓값 롤링으로 안정화(잠깐 미검출도 개수 유지).
    /dev/shm 개수 쓰기가 크게 줄어 로그 이벤트도 급감.
    - server.py: 대시보드에서 count 이벤트는 상단 배너만 갱신하고 로그 줄로
    안 쌓게 함(도배 방지). 음성 로그(heard/intent)는 그대로.
2026-07-29 vision: 개수 유지를 시간 기반 1분(TV_HOLD_SEC=60)으로 — 프레임수 대신 60초
    사용자 요청: 약 1분 여유로 체크. 최근 60초 안에 잡힌 최댓값을 개수로 유지
    (fps와 무관하게 정확). 토마토 치우면 1분 뒤 0으로 내려감.
2026-07-29 vision: 공중(부착)/바닥(낙과) 판정 + 공중 개수·위치 출력
    - 기준선(TV_GROUND_Y, 기본 600px)으로 각 토마토 중심 y를 판정:
    위=공중(초록박스), 아래=바닥/낙과(회색박스). 영상에 기준선·박스·위치라벨 표시.
    - 공중 토마토만 카운트(1분 시간유지 그대로), 위치[[x,y],...]를 /dev/shm/tomato_status
    JSON으로 매프레임 기록. SharedFrameSource가 읽어 개수 변할 때 개수+위치+낙과수 발행.
    - 대시보드: '공중 토마토 N개' 배너 + '위치: (x,y)... · 낙과 M개' 서브라인.
    검증(젯슨): 토마토 공중 판정 + 위치(753,343) 출력, 기준선/초록박스 표시 확인.
    기준선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
2026-07-29 vision: 개수 시간유지 60s->3s (TV_HOLD_SEC=3 서비스 환경변수)
    1분은 과해서 3초로. 서비스 파일에 명시적 Environment로 관리.
2026-07-29 dashboard: 영상·개수 상단 고정 + 로그 최신순(위로)
    - 상단(제목·개수·위치·영상)은 #top로 고정, #log만 아래에서 스크롤(flex
    column + overflow) → 로그를 내려도 영상이 항상 보임. #cam max-height 50vh.
    - 로그를 append→insertBefore로 바꿔 최신이 맨 위로. 트림도 lastChild(오래된 것).
2026-07-29 dashboard: 낙과 수·좌표가 갱신 안 되던 버그 수정 + 검증 보고서
    공중 개수(air)가 바뀔 때만 count 이벤트를 발행해서, 개수가 그대로면
    낙과 수와 좌표가 옛 값에 고정됐다(영상 오버레이 fallen:1 ↔ 배너 낙과:0).
    (air, fallen, positions) 중 하나라도 바뀌면 발행하고 5초 하트비트도 추가.
    좌표 지터 도배는 16px 격자 반올림으로 억제, LogHub.publish(latest_only=True)로
    상태 이벤트가 history 200칸을 밀어내지 않게 하되 새 접속자는 즉시 현재값 수신.
2026-08-05 dashboard: 수동 조작 화면(키보드 홀드 주행) + 하드웨어 없이도 뜨는 대시보드
    세 가지 실기 문제를 함께 잡았다(2026-08-05 젯슨 실기).
    1) 팔이 안 붙으면 서버가 아예 안 떴다
    run_voice가 _build_arm()을 제일 먼저 부르고 예외를 그대로 올려서,
    /dev/ttyACM0이 없으면 프로세스가 죽고 systemd가 3초마다 재시작만
    반복했다(실측 63회). 부스 데모에선 검은 화면보다 "장비 미연결"이라고
    떠 있는 게 낫다.
    - HTTP 서버를 하드웨어보다 먼저 띄운다.
    - 팔/바퀴/카메라/마이크는 각각 실패해도 Mock/None으로 대체하고 상태만
    페이지 상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
2026-08-06 base+arm: 펌웨어 v2(소음·끊김 해결) + 프리셋 10슬롯·리더암 미러링·높이 보간
    주행 "우우웅"의 원인은 통신이 아니라 PWM 50Hz(가청 대역)였다. 끊김은 별개로
    데드맨 하드컷 + 호출당 2초 DTR 리셋 대기가 원인. 둘 다 손봤다.
    펌웨어 v2 (mecanum_stable):
    - PWM 50Hz → 런타임 설정(기본 700Hz). PCA9685 상한은 1526Hz라 초음파 불가 —
    소음↔속도는 맞바꾸는 관계이므로 F/P/R로 실기에서 찾도록 열어둠
    - 5ms 틱 슬루(가감속), 소프트 데드맨(300ms 감속 / 1000ms 하드)
    - XOR 체크섬 *HH + strict 모드 자동 전환, V 무응답, hb에 링크 카운터(rx/bad)
    젯슨 (motor_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
    [BOTTOM.0001.ipt, BOTTOM.ipt, BOTTOM.stl, TOPLeft.0002.ipt, TOPLeft.ipt, TOPLeft.stl, TOPRight.0002.ipt, TOPRight.ipt]
2026-08-09 vision: 바닥 CSI 카메라(IMX219) + 라인 검출 → 메인 대시보드 출력
    CAM1에 Arducam RPi Cam v2.1(IMX219) 장착. jetson-io로 "Camera IMX219 Dual"
    오버레이 활성화(L4T R39.2.0에 드라이버 내장, 별도 설치 불필요).
    장치 충돌 해결:
    - CSI가 /dev/video0을 차지하면서 tomato_vision(인덱스 0 하드코딩)이 CSI를
    선점 → Argus "Failed to create CaptureSession"으로 라인캠 전체 마비.
    webcam을 /dev/v4l/by-id/ 안정 경로로 열도록 변경, 인덱스 폴백 제거
    (조용히 엉뚱한 카메라를 잡는 것보다 명확히 실패하는 게 낫다).
    파이프라인 (기존 /dev/shm 릴레이 패턴 재사용):
    - line-cam.servi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
    [line_follow.py, tomato_vision.py]
2026-08-09 fix: 리더암이 구동되던 포트 오인식 + 조용히 죽은 바퀴 링크 + 얼어붙는 영상
    실기에서 한꺼번에 터진 세 가지를 각각 근본 수정.
    1) **리더암이 토마토를 따던 문제** — resolve_arm_port()가 "USB_Single_Serial이
    들어간 첫 by-id"를 팔로워로 삼았다. 리더·팔로워가 둘 다 같은 CH343
    (1a86:55d3, product 문자열까지 동일)이라 이름으로는 구분이 안 되고,
    결국 **먼저 꽂힌 쪽/이름이 앞서는 쪽**이 팔로워가 됐다. 리더만 꽂힌 채
    서비스가 뜬 날 리더암이 팔로워로 열려 프리셋을 재생했다(id=6 Torque_Enable
    Overload error가 그 흔적). 시리얼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
    [arm.py, motor_link.py, ports.py]
2026-08-09 line: 코스 기하를 실측에 맞춰 재설계 (세로선 조향 → 가로 띠 거리유지)
    실제 코스를 보니 전제가 틀렸다. 테이프는 진행방향과 **나란히** 깔려 있고
    로봇이 그 위를 오간다 — 바닥 카메라에는 가로 띠로 보인다. 세로선 x-오프셋으로
    조향하는 통상적 라인트레이서 모델은 이 코스와 90도 안 맞았다("라인 없음").
    새 모델:
    - 띠의 세로 위치(band_y) = 무대까지 거리 → vx, 기울기 = 요 오차 → w,
    화면 가로 = 진행방향 → vy(게걸음)
    - 양끝 검은 테이프 = 코스 끝, 중간 색 마스킹테이프 = 스테이션(hue로 구분)
    색 분리를 밝기 → 채도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
2026-08-09 fix: 보드가 스스로 재부팅하면 PWM 튜닝이 조용히 날아가던 문제
    증상: 주행 중 가끔 대시보드에서 고른 주파수가 컴파일 기본값으로 돌아가고,
    사용자가 매번 손으로 다시 눌러야 했다.
    메커니즘(펌웨어 ↔ 젯슨 양쪽을 맞춰봐야 보인다):
    · 펌웨어는 리셋되면 setup()에서 PWM_HZ_DEFAULT/MAX_PWM=2000/슬루 6·12로
    되돌아간다. F/P/R은 RAM에만 있으므로 리셋 = 설정 소멸.
    · 젯슨은 그걸 되밀 준비가 돼 있었다 — 단 **연결 세대가 바뀔 때만**
    (JetsonBase._ensure_tuning). 그런데 세대는 MotorLink._open()에서만 올랐다.
    · 보드만 리셋되면 CH34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
    [motor_link.py]
2026-08-09 line: 라인 유지 주행 + 시각 오도메트리로 끝단 기준 변위 측정
    오늘 목표(라인트레이싱 하며 끝단 검은 테이프로 변위 파악)를 구현.
    변위 측정 — 엔코더 없이:
    - 바닥 카메라 연속 프레임의 위상상관(cv2.phaseCorrelate)으로 실제 이동량을 잰다.
    바퀴 슬립·배터리 전압과 무관하고 저속일수록 정확하다. 실기 신뢰도 0.82.
    - 누적값은 서서히 흐르므로 **양끝 검은 테이프에서 원점을 다시 잡는다**.
    양끝을 한 번씩 만나면 코스 전체 길이(span)가 잡혀 위치를 %로도 낸다.
    주행 제어 (hardware/line_drive.py, voice 서비스 안 — 포트를 MotorLin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
2026-08-09 line: 보정축을 vy(게걸음)로 바로잡고 부호 반전 + 런타임 축·부호 토글
    실기 확인 결과 축 대응이 반대였다. **테이프까지의 거리는 로봇의 횡방향 오차**라
    게걸음(vy)으로 잡아야 하고, vx(앞뒤)로는 테이프 거리를 만들 수 없다.
    따라서 보정=vy, 진행=vx. dy·yaw 부호도 둘 다 반대였다.
    이런 값은 카메라 장착 방향과 로봇 자세로 정해져서 원격에서 확정할 수 없다.
    그래서 코드에 박는 대신 **대시보드에서 즉시 뒤집고 파일에 남기도록** 했다
    (~/line_tuning.json — 서비스가 재시작돼도 유지. 모터 튜닝과 같은 방식):
    [보정축 vx↔vy] [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
2026-08-09 line: 출발 전 점검 — 기준선에서 너무 멀면 출발 자체를 거부하고 할 일을 알려준다
    기준을 다시 안 잡은 상태(코스 재설치·로봇 이동 후)에서 주행 버튼을 누르면
    출발하자마자 안전정지에 걸려 '눌렀는데 바로 멈춘다'로 보였다. 이제 출발 전에
    막고, [현재 위치를 기준선으로]를 누르라는 지시까지 메시지에 담는다.
2026-08-09 line: 회전(yaw) 보정 부호를 -1로 확정 (실기에서 거꾸로 나감)
    대시보드 [회전 부호 ±]로 뒤집어 ~/line_tuning.json에 저장됨. 코드 기본값도
    같이 맞춰, 새로 배포해도 처음부터 올바른 부호로 뜨게 한다.
    축·부호 3종 모두 실기 확정: 보정축=vy(부호-1) / 진행축=vx(부호+1) / 회전=-1
2026-08-09 line: yaw 발산 해결 — 각 추정 재작성 + 회전 보정 기본 꺼짐
    발산 원인은 부호가 아니라 **각 추정 자체가 쓰레기값**이었다. 좌/우 1/3의 무게
    중심 두 점으로 각을 냈는데, ① 표본이 2개뿐이라 잡음에 그대로 흔들리고
    ② 그 1/3 안에 띠가 아닌 밝은 것(흰 무대·반사·하얀 케이블)이 들어오면 중심이
    통째로 끌려갔다. 부호를 어느 쪽으로 두든 발산하는 게 당연했다.
    새 추정: **검출된 띠 행 범위 안에서만** 열별 중심 y를 구해 최소자승 직선을
    맞춘다(표본 수백 개). 합성 검증 — 기울기 ±5.4° 기대에 ±5.2° 측정, 화면에
    흰 방해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
2026-08-09 line: 색 캐스트에 안 무너지도록 임계를 전부 프레임 상대값으로
    카메라 AWB가 흔들려 화면이 보라빛으로 물들자 두 가지가 동시에 깨졌다:
    · 흰 테이프가 더는 "무채색"이 아니게 돼 절대임계 통과 픽셀 **0%** → TAPE LOST
    · 검은 끝마커의 채도가 프레임 최고(113 vs 중앙값 66)로 올라 "보라 스테이션"으로 오인
    구분 score중앙 테이프 절대임계90 통과
    중립 프레임 66 124 16.4% 정상
    보라 캐스트 7 58 0.0% 전멸
    절대값을 버리고 프레임 자기 통계 기준으로 바꿨다:
    테이프 = score 상위 8% & 중앙값+22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
2026-08-09 line: 색(스테이션) 구분 기본 꺼짐 — 배경색을 통제한 뒤에 켠다
    검출을 캐스트에 강하게 만들어도 "무슨 색인지"(hue)는 조명에 따라 그대로
    흔들린다. 지금 바닥은 원목이고 캐스트가 계속 움직여서 색 이름을 믿을 수 없다.
    배경을 도화지 등으로 통제하면 조건이 고정되므로, 그때 LF_COLOR=1로 켠다.
    [색 마커까지] 버튼은 꺼진 상태에서 왜 안 되는지와 무엇을 대신 쓸지
    (시간이동/끝까지)를 메시지로 알려준다 — 조용히 실패하지 않게.
2026-08-09 arm: 캘리브레이션 백업 + 프리셋 재매핑 도구(범위를 바꿔도 자세 유지)
    arm_presets.json의 .pos는 각도가 아니라 **캘리브레이션 상대 정규화값**이라,
    팔 범위를 다시 잡으면 교시해둔 슬롯 0~9가 통째로 어긋난다(리더암으로 전부
    다시 잡아야 함). tools/remap_presets.py가 옛 캘리브레이션으로 숫자를 절대
    엔코더 위치로 되돌린 뒤 새 기준으로 다시 적어 **같은 물리 자세를 유지**한다.
    lerobot 0.5.x motors_bus의 정규화 공식 그대로 구현(RANGE_M100_100 / RANGE_0_100),
    homing_offset 변화까지 보정. 항등변환 오차 0.004, 왕복변환 0.011, homing 왕복 0.008.
    새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
2026-08-09 arm: 팔 범위 캘리브레이션을 대시보드에서 (터미널 대화형 대체)
    lerobot-calibrate는 터미널에서 ENTER를 기다리는 대화형이라 원격/웹에서 못 돌린다.
    SOFollower.calibrate와 같은 절차를 이벤트 기반으로 다시 구현해 /control에 붙였다:
    ① [중앙에서 시작] 팔을 가동범위 한가운데 두고 누름
    → 토크 해제 + set_half_turn_homings()로 원점 재설정
    → 백그라운드에서 관절별 raw 최소/최대 기록 시작
    ② 손으로 모든 관절을 끝까지 움직임 (화면에 폭이 실시간으로 쌓임)
    ③ [완료 & 저장] write_calibration + 파일 저장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
2026-08-09 line/ui: 펄스(깔짝깔짝) 주행 + 화면을 운전/설정으로 분리
    주행 방식 — 연속 저속 대신 펄스:
    저속으로 계속 밀면 바퀴가 정지마찰을 겨우 넘나들며 붙었다 풀렸다 해서 갑자기
    쭉 미끄러진다. 짧고 빠른 펄스를 반복하면 한 걸음 거리가 일정해져 "버튼을 톡톡
    눌러 맞추는" 조작이 된다. 별도 모드가 아니라 **같은 설정의 양 끝**으로 융합했다:
    ON 시간 동안 speed로 구동 → 주기의 나머지는 완전 정지(정착)
    ON == 주기로 두면 연속 주행. 슬라이더 하나로 오간다.
    [◀ 톡] 버튼은 펄스 한 번 = 같은 걸음 반복. 검증: 0.10/0.40에서 ##..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
2026-08-09 docs: 2026-08-09 개발 노트 — 증상↔원인이 어긋난 사례와 진단 치트시트
    하루치 작업(모터 소음·끊김 → 프리셋/리더암 → 바닥 카메라 라인 주행 → 팔 재캘리브레이션,
    마지막에 ±1cm 편차 파지 성공)에서 **무엇에 속았고 어떻게 알아챘나**를 남긴다.
    핵심 3가지:
    ① 증상이 가리키는 곳과 원인이 있는 곳은 다르다
    소음=PWM주파수(통신 아님) / 라인분실=색캐스트(알고리즘 아님) /
    yaw발산=각추정(부호 아님) / 바퀴멈춤=보드 무증상 사망 / 리더암 오구동=포트식별
    → "둘 중 하나"인 문제를 두 번 시도해도 안 되면 그건 그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
2026-08-09 backup: 재캘리브레이션 후 프리셋·캘리브레이션·현장 튜닝값 (2026-08-09 세션 종료)
    팔 범위를 다시 잡고 슬롯 0~9를 재교시한 결과를 저장소로 끌어왔다.
    이 상태에서 **±1cm 편차 파지 성공**을 확인했으므로, 여기가 되돌아올 기준점이다.
    캘리브레이션 변화 — shoulder_pan 가동범위를 크게 넓혔다:
    shoulder_pan 1361~3051(폭 1690, 41%) → 711~3274(폭 2563, 63%)
    나머지 관절도 homing 재설정으로 값이 이동(wrist_roll은 한바퀴 고정 유지)
    프리셋: 슬롯 0~9 전부 + 이름
    0=대기 · 5=3번 따기준비 · 6=3번따기 · 7=담기 · 8=담기준비 · 9=놓기
    현장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
2026-08-10 line: 코스 극성 자동 판별 + Otsu 임계 + 지점 표식 다중 검출 (흰 도화지 코스)
    배경을 흰 도화지로 바꾸면서 테이프 극성이 뒤집혔다(원목 위 밝은 테이프 →
    도화지 위 어두운 테이프). 검출기가 테이프를 못 찾고, 오히려 그 테이프를
    "코스 끝(검은 마커)"으로 잡았다.
    전제를 고정하지 않도록 바꿨다:
    · **극성 자동 판별** — light/dark 두 가정으로 마스크를 만들어보고 가로 띠가
    실제로 만들어지는 쪽을 채택. 설정으로 두면 코스 바꿀 때마다 틀린다.
    · **임계를 백분위 → Otsu** — 백분위는 "테이프가 화면의 몇 %"를 가정하는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
2026-08-10 line: 지점(스테이션) 추적 + 찢어진 JPEG로 인한 검출 깜빡임 해결
    코스 구성 확정 — [주황]─[노랑]─[노랑]─[주황]
    지점0 좌측끝(토마토1) / 1,2 중간(토마토2,3) / 3 우측끝(바구니)
    노랑 2개는 **색으로 구분되지 않으므로** 세어야 한다. 그래서 주황(양끝)이
    절대 기준점 역할을 한다: 주황을 지나는 순간 인덱스가 확정되고(어느 끝인지는
    진행 방향이 알려준다), 그 뒤 노랑을 지날 때마다 ±1. 주황을 한 번도 안 지났으면
    인덱스는 **미확인**으로 두고 추측하지 않는다 — [지점 N] 버튼도 그때는 거부하고
    "먼저 끝지점을 지나가라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
2026-08-10 line: 보정을 비례제어 → 펄스 뱅뱅으로 (키보드 q/e처럼) + [정렬] 명령
    "키보드로 q/e를 톡 치면 아주 잘 맞는데 자동은 안 된다"의 원인 두 가지:
    ① **회전 보정이 아예 꺼져 있었다**(yaw_gain=0). 예전 발산 때문에 껐던 게 그대로였다.
    ② 켜도 안 됐을 것이다 — 보정 상한이 **70**으로 잘려 있었다. 사람이 q/e를 칠 때
    나가는 값은 속도 슬라이더 그대로(≈140)인데, 그 절반으로는 정지마찰을 못 넘는다.
    게다가 LINE_CORR_MIN(130)보다 상한이 작아 사실상 모순이었다.
    그래서 보정 방식을 사람 조작과 같게 바꿨다 — **이산 뱅뱅**: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
2026-08-10 line: 마커를 색 이름이 아니라 **역할**(끝점/중간지점)로 부른다
    주황 테이프가 OpenCV hue 6으로 잡혀 화면에 "빨강 스테이션"으로 떴다. 분류 자체는
    맞았지만(hue 0~18 → end) 표시가 색 이름이라 끝점인 걸 알아볼 수 없었다.
    조명에 따라 hue는 몇씩 밀리므로 **이름이 아니라 역할**을 보고해야 한다.
    · 역할 판정을 검출기(line_follow) 한 곳으로 모음 — 마커마다 role('end'|'mid')과
    한국어 라벨('끝점'|'중간지점')을 붙여 상태에 실어 보낸다.
    LineDriver는 그 결과를 그대로 쓴다(hue 창을 두 군데서 정하면 어긋난다 —
    옛 상태 파일용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
2026-08-10 line: 끝점에서 안 멈추고 발산하던 버그 + 펄스 해상도(톡톡이 주우웅 되던 것)
    ① 끝점에 도달했는데 [오른쪽 끝까지]를 누르면 쭈욱 넘어가 발산
    goto_end가 아직 **검은 끝마커**(end_marker)만 보고 있었다. 흰 도화지 코스는
    극성이 dark라 그 검출을 꺼놨으므로 목표를 영영 못 만나고 타임아웃(25초)까지
    밀고 갔다. 이제 **주황 마커(role='end')가 중앙에 오면** 도착으로 본다
    (원목 코스의 검은 테이프는 레거시 경로로 계속 지원).
    또 이미 끝점 위면 **출발 자체를 안 한다** — "이미 끝점에 있습니다"로 답하고
    변위 기준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
2026-08-10 line: 초록 경유 표식(위치 유지) + 멀면 길게·가까우면 톡톡
    ① 초록 테이프 = **경유 표식**(지점 아님)
    지점 간격이 멀어 카메라가 아무 마커도 못 보는 구간이 생기자 중간에 붙인 것.
    위치 추적을 끊기지 않게 하는 게 목적이므로 **지점 번호를 바꾸면 안 된다**:
    · 초록 통과는 지점 인덱스를 그대로 두고 "지점 사이 이동 중"만 기록
    · [다음 지점]은 초록에서 멈추지 않는다 — 안 그러면 절반에서 끝나버린다
    · 화면에 '경유'로 표시(끝점/중간지점과 구분)
    ⚠ 여기서 실제 버그를 하나 잡았다: _marker_kind가 end/mid만 r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
2026-08-10 line: 톡톡과 키보드가 달랐던 이유 — 정지 신호 폭주 + 송신 주기 저하
    "톡톡하는 것과 키보드 조작이 왜 다르냐"를 따라가 보니 구현이 실제로 두 군데 달랐다.
    ① **정지 신호 폭주**
    hold(0,0,0)이 하드 스톱 `S`를 보내고 있었다. 키보드는 뗄 때 한 번만 보내지만
    (브라우저 JS가 중복을 막는다), 펄스 주행은 OFF 구간마다 20ms 간격으로 불러
    **초당 50번의 S**가 나갔다. 펌웨어는 S마다 ①슬루 무시 즉시정지 ②"ok S" 응답
    ③I2C 8채널 재기록을 하므로 루프가 짓눌려 펄스가 불규칙해졌다.
    → hold()는 목표만 0으로 둔다(펌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
2026-08-10 backup: 라인 주행 현장 튜닝값 (펄스·속도 포함, 2026-08-10 세션 종료)
    set_params로 저장된 속도·펄스 설정이 처음으로 파일에 남았다. 축·부호만 있던
    이전 백업과 달리 이제 주행 감각까지 복원 가능하다.
2026-08-11 diag: 링크 실시간 계측 화면 — 1초 폴링으로는 80ms 펄스가 안 보인다
    라인 주행이 "톡톡"이 아니라 들쭉날쭉할 때, 원인이 지령 쪽(젯슨이 펄스를
    고르게 못 내보냄)인지 링크 쪽(보드가 못 받음)인지 펌웨어 쪽(받고도 슬루
    때문에 속도가 안 붙음)인지를 기존 /status로는 가를 수 없었다. 1초 스냅샷에
    80ms 펄스는 통째로 사라져서 셋 다 똑같이 "이상함"으로 보인다.
    voice/linkmon.py (신규) — MotorLink 목표를 100Hz로 뜨는 샘플러.
    · 지령 파형(vx,vy,w) 20초 링버퍼
    · 0↔비0 엣지로 펄스 ON/OFF 폭을 직접 측정 → LINE_PULSE_ON=0.08이
    실제로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
2026-08-11 diag: 기대 수신율을 상태에 따라 (정지 10/s · 주행 50/s)
    실기에서 바로 드러난 오탐 — 세워둔 로봇의 수신율이 10/s로 나오는데
    화면은 "기대 50/s"와 비교해 빨간불을 띄웠다. MotorLink는 아무도 지령을
    안 주면 IDLE_INTERVAL_SEC(0.1s)로 늘어지므로 정지 중 10/s가 **정상**이다.
    늘 빨간불인 경고는 경고가 아니다 — 정작 주행 중의 진짜 송신 지연을
    못 알아보게 된다. 파형에 최근 1초(ACTIVE_SEC) 안에 0 아닌 지령이 있었는지로
    주행 여부를 판정해 기대치를 바꾼다. 펄스 주행은 OFF 구간에 0을 보내지만
    그 사이 ON이 있으므로 MotorLink 쪽 판정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
2026-08-11 fw v2.1: 보드가 왜 재부팅하는지 스스로 자백하게 만든다
    증상: 2026-08-11, 2분 사이 보드가 28번 재부팅. 그런데 dmesg에 USB 이벤트가
    **하나도** 없었고 포트도 안 끊겼다(hb_resets=0). 즉 리셋은 통신선이 아니라
    AVR 자신에게서 나왔는데, 워치독(=loop 블로킹)인지 브라운아웃(=전원)인지
    구분할 방법이 없었다. 둘은 정반대 처방이 필요하다.
    ■ MCUSR은 못 쓴다 (실측으로 확인)
    이 보드의 부트로더는 MCUSR을 지우고 optiboot처럼 r2에 사본도 안 남긴다
    (mcusr=0x0, r2=0xAF ← MCUSR이 쓰지도 않는 상위비트가 켜진 잔여값).
    그대로 디코드하면 "WD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
2026-08-11 line: 주행은 전후·회전만 (게걸음은 정렬에서만) + 방향/정렬 버그 둘
    ■ 게걸음 금지 (요청)
    메카넘 횡이동은 롤러를 옆으로 미끄러뜨리며 가는 것이라 같은 거리에 힘이
    훨씬 많이 들고 슬립도 크다. 그래서 **주행 중에는** vx(전후)와 w(회전)만 쓴다.
    거리 오차를 되돌릴 수단이 없어지므로, 오차가 LINE_STRAFE_FIX_AT(0.15)를
    넘으면 주행을 접고 **정렬(톡톡)** 로 전환해 게걸음으로 잡은 뒤 이어서 재개한다.
    즉 게걸음이 사라지는 게 아니라 "꼭 필요할 때만" 나간다.
    · 재개 시 goal["started"]를 정렬에 쓴 시간만큼 밀어준다 —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
2026-08-11 line: 정렬에 전후 흔들기 — 메카넘은 멈춘 채로 옆으로 안 간다
    실기 보고: 정렬을 눌러도 오차가 안 줄었다. 이유는 보정 부호가 아니라
    **로봇이 아예 안 움직여서**였다. 메카넘의 횡이동은 롤러가 옆으로 굴러야
    생기는데, 정지 상태에서는 롤러의 정지마찰이 그걸 막는다. 바퀴가 이미
    굴러가고 있으면 마찰이 깨져 옆으로 밀린다 — 사용자 관찰 그대로:
    "살짝 전진 후진하면서 하면 좌우로 조금은 움직여지더라".
    → 정렬 펄스마다 전후로 살짝 흔든다(dither). 펄스마다 **부호를 뒤집으므로**
    전후 변위는 서로 상쇄되어 정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
2026-08-11 line: 크게 벗어나면 복구 수단이 잠기던 문제 — 정렬은 언제나 시도할 수 있다
    실기 보고: 3지점→2지점 이동 중 크게 튀어 dy=246px가 됐는데, 그 상태에서
    **아무것도 할 수 없었다.** 테이프는 멀쩡히 보이는데(사람 눈에도, 검출기에도)
    주행도 정렬도 안 되어 로봇을 손으로 옮겨야 했다.
    원인은 안전 한계(LINE_MAX_DY_NORM)가 **정렬에도** 걸려 있던 것:
    · _preflight() → 정렬 시작 자체를 거부
    · _safety_check() → 정렬 중에도 정지
    정렬은 "벗어남을 되돌리는" 동작인데, 바로 그 벗어남을 이유로 잠겼다.
    복구 수단이 복구가 필요한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
2026-08-11 line: 끝점이 어느 쪽인지는 테이프가 이어지는 방향으로 안다 (추측 금지)
    요청: 주황 끝점에 섰을 때 테이프가 오른쪽으로만 이어지면 여기가 제일 왼쪽(0),
    왼쪽으로만 이어지면 제일 오른쪽(3)으로 잡아달라.
    지금까지는 **진행 방향(_last_dir)으로 추측**했다. 그게 두 가지로 깨졌다:
    · 수동 조작으로 옮기면 방향이 직전 명령 값에 멈춰 있다 → 반대쪽으로 찍힘
    · 애초에 방향을 모르면(부팅 직후 0) 아무것도 못 정함
    코스는 한쪽으로만 이어지므로 **테이프가 이어지는 방향**이 훨씬 확실한 근거다.
    진행 방향을 몰라도, 손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
2026-08-11 line: 마커 재무장이 죽어 지점을 못 세고 끝까지 밀려가던 문제
    증상(2회 재현): 2번에서 1번으로 가라고 하면 톡톡 몇 번 치다가 쭈우우욱
    밀려서 1번을 지나치고 왼쪽 끝까지 가버린다. 마지막으로 센 마커가 늘
    'end'(주황)였다 — 1번(노랑)을 **한 번도 못 셌다**.
    원인: _observe_markers의 재무장 조건이 기하적으로 성립 불가능했다.
    if all(|m.x - center| > width*0.22 for m in markers): mark_armed = True
    이건 "지점 간격이 화면보다 넓다"를 전제한 조건이다. 실측은 정반대였다 —
    변위 749px에 2칸이었으니 **지점 간격 ≈ 375px**인데 화면은 1280px라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
2026-08-11 line: 주행 방식을 저속 연속 + vy·w 비례보정으로 (펄스는 정렬에만)
    관찰(사용자): 사람이 키를 눌러 몰면 줄을 잘 따라간다. 왜 되는지가 핵심이다 —
    **바퀴가 이미 구르고 있으면** 메카넘 롤러의 횡방향 정지마찰이 깨져 있어서
    작은 vy 보정도 그대로 먹는다. 멈춰 있을 때 큰 펄스(뱅뱅)가 필요했던 건
    정지마찰 때문이었지 제어가 나빠서가 아니었다. 즉 "굴러가는 중"이라는
    조건만 만들어 주면 평범한 비례제어가 통한다.
    그래서 주행 중에는
    · vx = 낮은 속도로 **연속** (펄스 게이팅 없음, 기본 105)
    · vy, w = 오차에 **비례**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
2026-08-11 line: 검출이 한 프레임 깜빡였다고 모든 버튼이 잠기면 안 된다
    신고: "테이프 없음이 뜨고 다음 지점을 눌러도 반응이 없다."
    실측하니 그 시점 전후로는 검출이 40/40 정상이었다 — 즉 **순간적인 깜빡임**에
    _preflight가 걸려 조작이 통째로 막힌 것이다. 검출은 프레임 단위로 깜빡일 수
    있고(찢어진 JPEG, 코스 끝에서 띠가 화면 밖으로 나가는 순간 등), 그때마다
    사람이 손쓸 방법이 없어지면 안 된다.
    · _preflight에 주행 중 정지 판정과 **같은 유예**(LINE_LOST_STOP_SEC=0.4s)를 준다.
    "그 안에 보였으면 출발해도 된다" — 진짜 안 보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
2026-08-11 line: 출발 한 방 + 주행 중 좌우 톡 — vx만으로는 바퀴가 안 풀린다
    실기: 0→1 이동에서 vx를 105로 **계속** 줘도 로봇이 안 나간다. 지령 파형은
    평평한 직선인데 바퀴가 안 도는 것 — 그 듀티로는 정지마찰이 안 깨진다.
    사용자가 찾아낸 방법이 그대로 답이었다: "중간중간 좌우 이동을 잠깐 섞어주면
    움직인다". 옆으로 톡 치는 순간 바퀴가 풀리고, 한 번 구르기 시작하면
    운동마찰은 정지마찰보다 작아 낮은 듀티로도 계속 굴러간다.
    정렬의 전후 흔들기와 **같은 원리, 반대 축**이다:
    정렬: 안 구르는 상태에서 vy를 먹이려고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
2026-08-11 line: 지점 이동 오버슈트 해결 — 감속→지점정렬(마커 중앙) + 가짜 마커 차단
    2026-08-11 실기 8장 분석. 사용자가 0→1→2→3을 오가며 겪은 것:
    사진1: 0→1 도착했지만 dy 110px로 벗어난 채 섬
    사진2·6·8: 사람이 [정렬톡톡]+[시간이동 0.1] 앞뒤 조합으로 마커를 화면
    중앙에 되돌리는 **수작업**을 매번 반복
    사진3: 1→2가 목표를 못 세고 변위 1936→3860px(5칸 분량)까지 폭주, 테이프 분실
    사진5: 1→2 이동은 했지만 지나쳐 벗어남
    사진7: 코스 오른쪽 끝을 지나 마루 타일 위 — **타일 무늬가 중간지점(h19~21)
    5개 +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
2026-08-11 line: 정렬이 지점 번호를 못 바꾸게 + 킥은 구르면 즉시 종료 + 마커 보이면 감속
    실사용 보고 셋을 한 번에.
    ■ "지점 정렬 중 1번이 2번이 되고 3번이 된다"
    두 구멍이 겹쳤다:
    · 정렬 펄스로 마커가 중앙 창(±154px)을 들락거릴 때마다 재무장→재계수.
    → 정렬(align/align_mark) 중에는 **계수 자체를 하지 않는다.** 정렬은
    "제자리 유지" 동작이다 — 번호는 이동만이 바꾼다. 띠 분실 중에도 세지
    않는다(근접 필터가 못 돌아 코스 밖 덩어리가 그대로 들어오므로).
    · 정렬 **직후**(idle) 정착 진동·검출 노이즈로 마커가 화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
2026-08-11 backup: 2026-08-11 세션 종료 — 현장 튜닝 스냅샷 + 개발노트
    젯슨 런타임 파일 스냅샷(끌어옴):
    · base_tuning.json: 50Hz(잔재!) → **700Hz · 듀티 2600 · 슬루 23/12**
    — /diag가 발각한 그 값. 파일이 코드 기본값을 덮으므로 이 스냅샷이 기준.
    · line_tuning.json: 주행=저속연속(smooth=1) 순항 105 · 킥 155 · 좌우톡 120 ·
    정렬 흔들기 130 · 펄스 112/0.08/0.2 · 축부호(dy -1, yaw -1, travel +1)
    · arm_presets.json 스냅샷 갱신.
    docs/개발노트-2026-08-11.md: 오늘 하루의 증상→오진→진짜 원인 기록.
    ① 정지마찰이 제어 문제로 위장한다(주행 방식 대전환의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
2026-08-11 line: 끝점에서 "테이프 없음" — 띠 가로지름 임계 35%→28%
    실사고: 좌측 끝점 정위치에 서 있는데 "테이프 없음(dark: 띠가 화면을 안
    가로지름, 최대 34% < 35%)"이 떠 모든 주행 버튼이 출발 전 점검에서 거부됐다
    ("로봇이 안 움직여"). 거부 메시지는 화면 아래 #out에만 떠서 눈에 안 띈다.
    **코스 끝점에서는 테이프가 화면을 다 가로지르지 못하는 게 구조적으로 정상**
    이다 — 왼쪽 끝이면 오른쪽으로만 이어지니 화면의 1/3~1/2만 덮는다. 34%는
    정위치 값이었다. 코스 밖 이탈(우측 끝 너머 타일)은 22%였으므로 0.28은
    "끝점 정위치"와 "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
2026-08-11 line: 포맷 예외 하나가 라인 주행 전체를 40분간 죽였다 — 스레드 방벽
    실사고(21:46): 정렬 중 테이프가 깜빡 사라진 순간 —
    _align_error는 None을 0으로 보므로 "오차 0 = 정렬 완료"가 됐고,
    완료 메시지의 f"{offset_y_px:.0f}"가 None을 받아 TypeError
    → line-drive 스레드 사망.
    그 뒤가 더 나빴다: 상태 API는 **마지막 스냅샷을 계속 내보내서** 화면엔
    "테이프 없음(낡은 사유)"이 고정된 채 모든 버튼이 무반응 — 죽었다는 사실
    자체가 화면에 안 보였다. 원시 검출 파일은 멀쩡히 갱신되는데(40/40 found)
    드라이버 상태만 얼어 있는 불일치 +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
2026-08-11 dashboard: 서비스 재시작 버튼 — 팔이 굳었을 때 ssh 없이 되살린다
    배경: 팔이 안 움직임(저널에 Torque_Enable Overload 재시도 흔적). 팔·바퀴
    연결은 tomato-voice 프로세스가 들고 있으므로 그 재시작이 곧 재연결이다 —
    현장에서 ssh 없이 누를 수 있는 손잡이가 필요했다.
    · /settings [서비스] 카드: tomato-voice(팔·음성·바퀴) / line-follow /
    line-cam / tomato-vision 재시작 + [상태 확인](is-active 일괄).
    · /control 리더암 줄에도 [🦾 팔 서비스 재시작] — 팔이 굳는 순간 있는 화면.
    · 구현: sudo -n sh -c "sleep 1 && systemctl restart <이름>" 분리 실행 —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
2026-08-11 dashboard: 재시작 버튼이 조용히 실패하던 것(polkit) + 배지가 영영 "확인 중"이던 것
    ■ 서비스 재시작 버튼이 아무것도 안 했다
    tomato-voice.service의 CapabilityBoundingSet=CAP_NET_BIND_SERVICE가 자식
    프로세스의 권한 상승을 커널 수준에서 차단한다 — sudo가 "unable to change
    to root gid"로 죽고, 버튼은 성공이라고 답한 채 아무 일도 안 일어났다.
    → sudo를 버리고 polkit 규칙(deploy/50-tomato-services.rules)으로.
    systemctl은 D-Bus로 systemd에 부탁하는 방식이라 프로세스 자신의 권한
    상승이 필요 없다. 규칙 = "server 계정은 이 네 유닛의 restart/start/stop만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
2026-08-11 arm: 팔로워 컨트롤러 사망(과전압 의심) — 리더암 보드를 팔로워에 이식
    팔로워 컨트롤러(5AE6055389)가 USB에서 완전히 사라졌다(열거 시도 흔적조차
    없는 무신호 — 부팅 때 1초 잡혔다 끊긴 게 마지막). 사용자 판단: 과전압으로
    사망(전날 배터리 방전→재부팅 폭풍 시간대). 두 팔의 컨트롤러는 같은 모델이라
    리더암 보드를 팔로워암에 물려 쓰기로 함.
    · ARM_FOLLOWER_SERIAL ↔ ARM_LEADER_SERIAL 맞바꿈(팔 구분은 시리얼로만 한다는
    원칙 그대로 — 보드가 이동했으니 시리얼도 따라간다).
    · 서보 캘리브레이션은 서보 EEPROM + 호스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
2026-08-12 seq: 팔+지점 이동 혼합 시퀀스 · 지점 정렬을 될 때까지 · 시작이 한 곳에서 안 굳게
    ■ 시퀀스 (요청) — hardware/sequence.py
    수확 데모는 "팔만"도 "주행만"도 아니라 둘을 번갈아 한다. 한 줄 대본으로:
    숫자=팔 프리셋 · m숫자=지점 이동 · w초=대기
    예) m0 1 2 3 7 m3 8 9 0
    · 지점 이동은 **도착까지 기다린다** — LineDriver는 논블로킹이라 그냥 두면
    주행 중에 팔이 움직인다. mode가 idle로 돌아올 때까지 대기.
    · 이동이 실패(테이프 분실·타임아웃)하면 **거기서 끊는다** — 엉뚱한 위치에서
    팔을 뻗으면 안 된다. 검증: 실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
2026-08-13 vision: 6개 중 2개만 잡히던 건 조명이 아니라 해상도였다 — imgsz=1280
    가까운 왼쪽 화분 2개만 박스가 붙고, 더 크고 밝게 보이는 가운데·오른쪽 4개는
    전혀 안 잡혔다. predict()에 imgsz를 안 줘서 ultralytics 기본값 640으로 추론
    중이었고, 1280x720이 640x384로 축소되며 먼 열매 넷이 검출 한계 아래로 내려간
    것. 그래서 "먼 게 안 잡힌다"가 아니라 "가까운 것만 잡힌다"였다.
    원본 프레임 5장 스윕: imgsz 640은 conf 0.10에서 1.2/6, 1280은 conf
    0.02~0.10 전 구간에서 6/6. conf 0.005까지 내려도 오검출 0건 —
    사람·박스·로봇팔이 있는 배경인데도. 박스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
2026-08-13 voice: 위/아래 토마토 구분 + "N번 이동" · 발음을 접어서 오인식을 흡수한다
    ■ 오인식 내성 — 낱말을 더 적는 대신 발음을 접는다 (voice/korean.py)
    지금까지는 관찰된 오인식을 손으로 목록에 넣어 왔다("도마도","또마또",
    "도루도"…). 그 방식은 처음 보는 변형을 못 잡는다. 한국어 STT 오류가 몰리는
    갈래는 정해져 있어서, 비교 전에 그걸 접어버리면 목록이 필요 없어진다:
    파열음 세기(ㄷ·ㄸ·ㅌ→t), 받침 끝소리 7종 중화, ㅐ=ㅔ, 초성 ㅇ 탈락.
    접고 나면 "도마도/또마또/도마토"는 "토마토"와 **글자 그대로 같아진다**.
    남는 변형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
2026-08-13 line: 정렬 "완료" 범위를 설정에서 — x±50 · y 아래50/위20 · 회전 ±2°
    ■ 완료 기준을 주행 보정 데드밴드에서 떼어냈다 (요청)
    둘은 다른 질문인데 같은 값(LINE_DY_DEADBAND=0.05)을 쓰고 있었다.
    데드밴드 = "지금 보정을 낼까" · 완료 = "이제 그만해도 되나"
    그래서 이런 일이 생겼다: 지점 정렬 → 조건 충족 → 0.8초 정착 대기 →
    다시 재보니 데드밴드를 살짝 넘음 → "정착 후 재측정, 다시 맞춥니다" →
    끝나지 않는 재정렬. 사람이 [지점 정렬]을 계속 누르게 되던 그 증상이다.
    ■ 범위는 정규화 비율이 아니라 **px**로 준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
2026-08-13 voice: 바구니를 지점0으로 · 명령어를 대시보드에서 고칠 수 있게
    바구니는 첫 화분 오른쪽에 놓기로 해서 지점0이 토마토1과 바구니를 겸한다.
    수확 대본이 m3 → m0, "바구니" 명령도 지점0. 지점3(우측 끝)은 당분간 안 쓴다.
    "1번 이동"과 "바구니"가 같은 곳으로 가는데, 겹치는 게 의도된 배치다.
    ■ 명령어를 코드에서 꺼냈다 (voice/words.py)
    축·부호, 모터 튜닝, 시퀀스와 같은 원칙 — 코드 값은 출고 기본값이고 현장에서
    고른 값이 이긴다. 음성은 특히 그렇다. 마이크·사람·주변 소음이 바뀌면 잘 걸리는
    낱말도 바뀌는데, 그때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
2026-08-13 voice: 설정 화면 힌트에 마크다운이 그대로 보이던 것
    힌트는 innerHTML로 들어가는데 **강조**를 마크다운처럼 적어 놔서 화면에
    별표가 그대로 찍혔다. <b>로.
2026-08-13 voice: "안녕"이라고 부른 뒤에만 명령을 받는다 + 영상과 로그를 같이 보이게
    ■ 호출어 게이트 (voice/wake.py)
    마이크는 늘 켜져 있고 부스에는 사람이 말한다. 낱말을 아무리 잘 고르고 근사
    매칭을 조여도 옆 대화가 언젠가는 명령으로 읽히는데, 그때 실제로 바퀴가 구른다.
    부른 뒤에만 받게 해 그 사고를 구조적으로 막는다.
    배포 직후 실기 로그에 바로 증거가 남았다 — 주변 대화가 "위(2층) 토마토 따기",
    "아래(1층) 토마토 따기"로 두 번 읽혔고 둘 다 게이트에서 차단됐다. 게이트가
    없었으면 그 순간 팔이 나가고 베이스가 굴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
2026-08-13 line: 출발 한 방이 도달할 수 없는 코드였다 — 감속 가드 제거
    슬라이더를 올려도 아무 일이 없다는 보고. 값은 정상이었다 —
    travel_kick=150이 런타임에도 ~/line_tuning.json에도 그대로 들어가 있었다.
    막힌 곳은 실행 경로였다:
    if not braking:
    use = self._travel_kick(goal, use)
    `braking`은 다음 지점 마커가 **반화면(640px)** 안에 들어오면 참이 된다.
    그런데 이 코스는 지점 간격이 ≈375px다 — 출발하는 순간 이미 감속 구간이고,
    심지어 방금까지 서 있던 마커가 "앞쪽 마커"로 잡힌다(실측: 마커 x=669, 중앙
    +29px). 그래서 킥은 **한 번도 실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
2026-08-13 line: 지그재그가 항상 나무 쪽부터 나가던 것 — 시작쪽을 정한다
    "지그재그 게걸음 할 때 반대쪽부터 먼저 가게 해줘. 항상 토마토 나무와 부딪힌다."
    옆으로 흔드는 곳이 세 군데인데 셋 다 시작 방향이 문제였다:
    · 주행 좌우 톡(_travel_wiggle) — 첫 펄스가 _wiggle_n==1이라 **항상 −쪽**
    · 굳음 해제의 직각 흔들기 두 곳 — 부호를 벽시계(int(monotonic()*6)%2)로
    정해서 **시작 순간의 방향이 매번 달랐다.** 운이 나쁘면 나무 쪽이었다.
    지그재그는 부호가 교대라 결국 제자리로 돌아온다. 하지만 **첫 반 주기는 한쪽으로
    나간다**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
2026-08-13 line: 중간지점 다 들르기 · 흔들 때 회전도 · 각도 10° · 벗어나면 스스로 붙이기
    ■ 두 칸 이상은 한 칸씩 간다 (토글: [중간지점 들르기 켜기/끄기])
    0→3을 0→1→2→3으로 나눠 간다. 도착할 때마다 다음 칸을 **같은 틱에서** 시작한다 —
    cancel로 가면 mode가 idle이 되고 시퀀스 러너가 그걸 "도착"으로 읽어 주행 중에
    팔이 나간다. 우회(_maybe_detour)·도착정렬은 _start를 안 거치므로 연쇄가 살아남고,
    새 명령이 들어오면 _start가 연쇄를 지운다.
    **중간에서는 정렬을 하지 않는다**(요청). 칸마다 정렬하면 수 초씩 붙어 너무 느리다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
2026-08-13 seq: 자세와 자세 사이에 0.3초 — 관성이 죽고 다음 자세로
    프리셋을 붙여서 재생하면 앞 동작의 관성이 남은 채 다음 목표가 들어간다.
    자세가 뭉개지고 집게가 열매를 스치듯 지나간다. 짧게라도 세워 흔들림을 죽인다.
    **사이에만** 넣는다. 마지막 자세 뒤나 지점 이동 앞에 넣으면 정착이 아니라 그냥
    지연이다 — 시퀀스 러너는 다음 단계가 또 자세일 때만 쉬고, 팔의 연속 재생
    (_play_sequence: demo_move·프리셋 나열)은 두 번째 자세부터 쉰다.
    대기는 _stop.wait로 — 통짜 sleep이면 그 0.3초 동안 [시퀀스 정지]가 안 먹는다.
    특정 구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
2026-08-13 line: 코스를 4지점 → 3지점으로 (지점3 제거, 지점2가 종착)
    [주황]────[노랑]────[주황+검은띠]
    지점0 지점1 지점2
    토마토1 토마토2 토마토3
    +바구니 (종착)
    옛 지점3(우측 끝 · 바구니)을 없앴다. 바구니는 첫 화분 오른쪽 — 지점0에 겹친다.
    옛 지점1·2가 둘 다 노랑이었는데 지점2가 종착이 되었으므로 주황으로 바꾼다.
    지점 인덱스에 기대는 코드는 전부 len(LINE_STATION_LABELS)로 쓰여 있어 라벨
    한 줄만 고치면 따라온다 — 끝점 래치(0 ↔ len-1), 번호 선언, 대시보드 버튼,
    음성 매핑, 한 칸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
2026-08-13 harvest: 화면의 토마토를 나무·높이로 읽고 딸 순서를 정한다 (+자동 모드)
    지금까지 "위 토마토 따줘"는 **사람이 어느 나무 앞인지 알고** 말해야 했다.
    화면엔 이미 좌표가 다 있었는데 그걸 "어느 나무의 몇 층"으로 읽어주는 층이
    없었을 뿐이다. harvest.py가 그 층이다.
    ■ 판단 규칙
    · 나무 = 화면 **x 경계**로 가른다. 무대 카메라가 바닥에 고정이라 x가 곧 나무다.
    검출된 걸 x로 정렬해 순서대로 배정하면 한 그루가 안 잡히는 순간 나머지가
    통째로 밀려 엉뚱한 나무로 간다 — 경계는 고정이라 그런 일이 없다.
    · 높이 = y 하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
2026-08-13 harvest: 고정 좌표를 버리고 무대를 관측에서 배운다
    "위치가 달라질 수도 있잖아. 배경이 변할 수도 있어." — 맞는 지적이었다.
    나무를 화면 x의 **정해진 경계**(357/595)로 갈랐는데, 그러면 무대나 카메라가
    조금만 움직여도 배정이 통째로 어긋난다. 절대 좌표를 쓴 게 잘못이었다.
    ■ 상대 구조로 바꿨다
    · 나무 = 열매 x를 **간격으로 묶는다**. 같은 나무의 열매는 x가 붙어 있고 나무
    사이는 훌쩍 벌어진다 — 문턱을 "가장 큰 틈의 40%"로 잡으면 무대가 어디로
    옮겨가도 같은 구조가 나온다. 하한(120px)은 한 그루만 보일 때 그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
2026-08-17 3D: 베이스 하판 수정 (BOTTOM 재출력용 STL 갱신)
    인벤터 롤링 백업이 0001을 밀어내고 0003을 남김 — 그대로 따라간다.
    [BOTTOM.0001.ipt, BOTTOM.0003.ipt, BOTTOM.ipt, BOTTOM.stl]
2026-08-17 line: 띠 두께를 "맨 위~맨 아래 거리"로 재던 것 — 밑단 마루 30px이 멀쩡한 띠를 죽였다
    바닥 카메라에 테이프가 또렷하게 찍혀 있는데 "테이프 없음"이 떴다. 오늘 세 장면에서
    연속으로 같은 증상이 났고, 원인도 셋 다 같았다.
    자격 행(폭의 28% 이상을 가로지르는 행)을 골라 놓고 두께를
    thick = band.max() - band.min() + 1
    로 쟀다. 이건 **띠의 두께가 아니라 맨 위 자격행에서 맨 아래 자격행까지의
    거리**다. 화면에 가로로 긴 것이 하나만 더 있으면 진짜 띠와 통째로 묶이고,
    그 사이 빈 도화지까지 두께로 세어진다.
    ■ 실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
2026-08-17 presets: 프리셋 슬롯 10 → 20 (Shift+숫자로 10~19)
    슬롯 0~9가 이미 꽉 찼다. 지금 현장 파일이 딱 열 칸이다:
    0 대기 · 1 2층 사전준비 · 2 2층준비 · 3 2층 잡기
    4 1층 사전준비 · 5 1층준비 · 6 1층 잡기 · 7 잡아서 땡기기 · 8 놓을준비 · 9 놓기
    한 층을 따는 대본이 사전준비→준비→잡기로 3칸을 먹고, 위/아래 두 벌에 대기·땡기기·
    놓기까지 넣으면 남는 칸이 없다. 새 자세를 시험하려면 기존 걸 덮어써야 하고, 아니다
    싶으면 되돌릴 방법이 다시 교시하는 것뿐이었다.
    ■ 한 상수로 정한다
    hardware/presets.py: SLOT_COUNT = 20
    여기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
2026-08-17 harvest: 우연히 지나간 프레임 하나가 무대를 영구히 정의하던 것
    현장에서 가운데·오른쪽 열매가 **왼쪽·가운데**로 찍혔다. 계획기는 멀쩡했다 —
    자를 잘못 들고 있었다.
    배운 무대 : 나무 x = [188, 937, 1258]
    보이는 열매: x = 539, 897
    나무0+1 = 391px ← DP가 고름 나무1+2 = 759px ← 실제 정답
    배정 DP는 순서 규칙을 정확히 지키면서 최선을 냈다. 기준이 엉터리였을 뿐이다.
    ■ 어쩌다 그런 값을 배웠나
    SceneModel이 메모리에만 있어서 **서비스를 재시작하면 학습이 통째로 날아갔다**
    (프리셋 20개 배포 때 재시작한 게 방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
2026-08-17 line: 코스를 3지점 → 2지점으로 · 이제 색 하나가 곧 지점이다 (셈을 버렸다)
    [노랑]──────────────[주황]
    지점0 지점1
    토마토1 토마토2
    옛 지점2(우측 끝 · 토마토3)를 없앴다. 화분도 2그루로 줄인다 — 무대에 3그루가
    남아 있으면 비전이 계속 세 묶음으로 보고 SceneModel이 2그루를 못 배운다.
    ■ 셈을 버렸다 (이번 변경의 핵심)
    예전엔 노랑이 여러 개라 색만으로는 몇 번째인지 몰랐다. 그래서 주황(양끝)을 절대
    기준점으로 잡고, 그 뒤로 마커를 지날 때마다 *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
2026-08-17 harvest: 바구니에 담은 토마토를 15초마다 다시 따러 가던 것 — 구역이 셋인데 선이 하나였다
    로그가 같은 줄을 반복하고 있었다:
    15:56:34 [수확] 왼쪽 · 토마토1 1층(아래) 따기 → 바구니
    15:56:19 [수확] 왼쪽 · 토마토1 1층(아래) 따기 → 바구니
    15:56:03 [수확] 왼쪽 · 토마토1 1층(아래) 따기 → 바구니 (picked 14회)
    왼쪽 나무에는 열매가 없었다. 그 "토마토1 1층"은 **이미 따서 바구니에 담아 둔 것**이다.
    ■ 세 겹이 겹쳐서 하나도 못 걸렀다
    · y — 바구니 열매가 y=594. 비전의 낙과선이 600이라 **6px 위**라서 '공중'으로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
2026-08-17 line: 접근/정밀 국면을 없앴다 — 설정한 듀티 하나가 전 구간에 그대로 나간다
    "분명 톡톡인데 왜 연속주행처럼 발산했지?" — 톡톡 안에 연속에 가까운 국면이
    숨어 있었다. /diag의 펄스 폭이 그대로 자백하고 있었다:
    최근 ON 폭: 120 100 120 120 120 120 120 130 | 290 310 290 270 | 130 100 100 100
    최소 100 · 평균 135 · 최대 310 → 편차 210ms (±156%)
    290~310ms는 LINE_COARSE_ON(0.30)이다. 목표 마커가 화면 중앙 ±384px 안에 없으면
    '접근(coarse)'으로 보고 ON 0.30/주기 0.34 — **88% 듀티**로 갔다. 코드 주석에도
    "거의 연속 주행"이라고 적혀 있던 국면이고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
2026-08-17 line: 초록 마커는 인식을 못 한 게 아니라 **밝기 게이트에 먹히고 있었다**
    "초록색을 그간 인식하지 않는 줄 알고 뺐다" — 정확한 관찰이었고, 원인은 hue 창이
    아니었다. 초록은 hue 창(41~90) 안에 잘 들어와 있었다.
    실측(2026-08-17 현장 프레임): 초록 마커 H=73 S=104 V=83
    주행 테이프 H=157 S=76~82 V=57~64
    배경 med_v=133 → '어두움' 문턱 = 133-40 = 93
    색 마커를 뽑을 때 `(S > 채도문턱) & ~dark_mask`를 썼는데, dark_mask가 V<93이다.
    **초록의 V가 83이라 99%가 제거됐다.** 관문별로 찍어보면:
    ① 채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
2026-08-17 line: 기준선에서 크게 벗어났을 땐 흔들기가 멀어지는 쪽으로 안 친다
    현장 요청: "지점 정렬하는데 Y축으로 상당히 떨어진 상황(>100px)일 땐 톡톡 칠 때
    멀어지는 방향으로는 안 쳤으면 좋겠어."
    화면의 `지점 정렬 — 마커가 굳어 흔들어 풀기 #4`가 그 구간이다. 진행축이 굳으면
    **직각축을 흔들어** 바퀴를 굴리는데, 그 직각축이 곧 **기준선까지의 거리축(Y)** 이다.
    _cross_shake()는 부호를 교대하므로 반은 기준선 쪽, 반은 반대쪽으로 나간다.
    dy=-312px처럼 이미 크게 벗어난 상태에서는 그 반 주기가 오차를 그대로 키운다.
    ■ 왜 원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
2026-08-17 line: 회전 보정이 물리적으로 0이었다 — 게걸음 슬라이더가 회전까지 잘랐다
    "각도 부호를 뒤집든 말든 항상 각도가 멀어지는 방향으로 간다."
    그 말이 정확했다. **0에 부호를 붙여도 0이다.**
    ■ 실측 (젯슨 실기, 제자리, 펄스 0.12s)
    w= 75 → 0.00° w=100 → 0.45° w=120 → 1.10°
    w=140 → 1.95° w=160 → 3.20° w=180 → 4.35°
    정지마찰 문턱 w≈90, 그 위로는 기울기 0.043°/단위로 깔끔하게 선형.
    회전축은 멀쩡했다(부호도 맞다: +w → 각도 +). 문제는 **크기**였다.
    회전 보정은 게걸음과 같은 _corr_pulse를 거쳤고, 크기가 corr_m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
2026-08-17 line: 지점 정렬 발산 — 굳은 게 아니라 지령이 문턱 아래였다
    회전과 **똑같은 병이 진행축에도 있었다.** 실측(젯슨 실기, 펄스 0.12s):
    지령 60 → 2.2px 110 → 35.7px
    75 → 2.9px 130 → 95.7px
    90 → 9.3px 150 → 230.1px
    _mark_pulse의 크기 하한이 게걸음 슬라이더(corr_min, 현장 60)였다. 마커가 중앙에
    가까워져 0.6×|dx|가 작아지면 60이 나가는데, **60은 2.2px밖에 안 간다.**
    dx가 20이든 60이든 100이든 전부 60이 나갔으니 마커는 영영 중앙에 안 왔다.
    그걸 코드는 "마커가 굳었다"로 읽고 격렬하게 흔들었다. 흔들기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
2026-08-17 line: 띠는 한 프레임에 순간이동하지 않는다 — 마루 경계를 띠로 잡던 것
    2026-08-17 실기: 코스 오른쪽 끝을 지나쳐 서자 화면에 테이프가 왼쪽 23%만 남아
    행 임계(28%)를 못 넘었고, 대신 **아래쪽 원목 마루 경계**가 띠로 뽑혔다.
    band_y 360 → 703 (한 프레임에)
    dy 1.5px → 343px
    found True ← 자신 있게 내보냈다. odom은 130px밖에 안 움직였는데.
    로봇이 옮겨간 게 아니라 **다른 것을 잡은 것**이다. 그 값을 믿고 지점 정렬이 돌면
    엉뚱한 데로 간다(직전 세션의 발산이 그 경로였다).
    ■ 연속성 검사
    바닥의 띠는 한 프레임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
2026-08-17 base: drive(seconds)가 구동 시간을 100ms 단위로 올림하고 있었다
    현장 지적: "회전 명령 넣을 때 보드가 이상하네, 좀 오랫동안 쭈욱 밀려나네."
    while time.monotonic() < deadline:
    self._link.set_velocity(vx, vy, w)
    time.sleep(0.1) # ← 항상 100ms를 잔다
    루프가 100ms씩 자니 실제 구동 시간이 **다음 100ms로 올림**된다:
    부탁 0.12s → 실제 0.2s (+67%) 부탁 0.35s → 실제 0.4s
    부탁 0.20s → 실제 0.2s 부탁 0.50s → 실제 0.6s
    짧은 "톡"일수록 오차 비율이 커진다. 그게 "톡 쳤는데 쭈욱 밀려난다"의 정체다.
    재전송은 MotorLink 스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
2026-08-17 line: 지점 정렬 순서를 뒤집었다 — 각도 먼저, 그 다음 x
    회전은 제자리 회전이 아니다. 회전 중심이 카메라에서 벗어나 있어서
    (실측 d_x≈-178px, d_y≈-950px) **1도 돌 때마다 카메라가 진행축으로 ≈17px 밀린다.**
    그런데 정렬은 `1단계 마커 x → 2단계 dy/각도` 순서였다. **거꾸로다** — x를 애써
    맞춘 뒤 각도를 잡는 순간 방금 맞춘 x가 깨진다. 정렬 x 허용범위가 ±60px이니
    3.5도만 돌려도 그것만으로 범위를 벗어난다. 정렬이 잘 안 끝나던 이유 하나다.
    1단계 각도 → 2단계 마커 x → 3단계 거리(dy)
    각도가 잡힌 뒤의 x 펄스는 회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
2026-08-17 line/harvest: 끝점에서 띠를 잠깐 놓친 것이 수확 전체를 끝내던 것
    현장: "끝점에서 테이프를 잠깐이라도 놓치게 되면 바로 시퀀스가 멈춰버려."
    로그 그대로:
    19:54:40 [수확] 오른쪽·토마토2 2층(위) — 우측 끝·주황·토마토2·종착(으)로 이동
    19:54:49 [수확] 이동이 끝나지 않아 중단합니다
    ■ 안전장치 둘이 서로를 트리거하고 있었다
    · LINE_LOST_STOP_SEC = **0.4초**. 이 시간 넘게 띠를 못 보면 정지한다.
    · 띠 연속성 검사(어제 넣은 것)는 점프를 최대 **10프레임 ≈ 0.67초** 거부한다.
    → 연속성 검사가 한 번 걸리는 것만으로 0.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
2026-08-17 line: 정렬 흔들기가 맞춰 놓은 걸 도로 밀어내고 있었다 — 무한 진동
    "지나친다"고 본 것은 지나침이 아니라 **끝나지 않는 진동**이었다. 촘촘히 찍으니
    증거가 그대로 나왔다:
    t=13.25 mark_dx = -0.3 ← 완벽하게 중앙
    t=13.75 "정착 후 재측정 — 0px 밀림, 다시 맞춥니다 (#6)"
    t=14.25 mark_dx = +70 ← 스스로 밀어냈다
    odom이 1350 ↔ 1495 로 **±70px씩 끝없이 왕복**했다. x가 허용범위(±60px) 안이라
    진행축 펄스는 안 나가는데도 로봇이 계속 움직였다.
    ■ 범인은 정렬 흔들기(dither)다
    흔들기는 게걸음/회전이 정지마찰을 넘도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
2026-08-17 line: 조명이 물들면 테이프를 놓치던 것 — 대비가 무너진 게 아니라 마스크가 너덜너덜해진 것
    현장: "실제로는 테이프 범위에 있는데 배경이 잠깐이라도 빨개지면 인식을 못 해."
    실패로 넘어가는 순간의 프레임을 직전 성공 프레임과 짝지어 모아 봤다. 두 갈래였고,
    그중 한 갈래가 이것이다 — **화면 전체가 마젠타로 물든 프레임**(무대 조명).
    med_s가 평소 8~22에서 **97~98**로 치솟는다.
    ■ 왜 하필 이 코스에서
    자주색 테이프와 마젠타 조명은 **같은 색 계열**이라 테이프만 밝아진다:
    정상 조명 : 테이프 V=59 종이 V=145 →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
2026-08-17 deploy: 젯슨 현장 설정을 스냅샷으로 백업 + 오늘의 교훈을 CLAUDE.md에
    ■ 젯슨에만 있던 것들을 저장소로
    오늘 하루 종일 실기로 값을 고쳤는데 그게 전부 젯슨 홈에만 있었다. 보드가 죽거나
    재플래시하면 통째로 날아간다(오늘 브라운아웃으로 한 번 리부팅했다).
    deploy/line_tuning.snapshot.json 축·부호·펄스·게걸음·흔들기(현장 확정값)
    deploy/base_tuning.snapshot.json 700Hz · 듀티 2600 · 슬루 23/12
    deploy/sequences.snapshot.json 대본 A/B/위/아래
    deploy/voice_words.snapshot.json 현장에서 고친 음성 낱말
    deploy/voice_wake.snapshot.jso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
2026-08-22 line: 마룻바닥 경계를 테이프로 잡고 있었다 — "가로지름이 가장 큰 것"이 틀린 기준이었다
    대시보드는 "테이프 인식"이라 말했지만 초록 검출선은 화면 맨 아래 마룻바닥
    경계에 가 있었다. 진짜 자주색 띠는 화면 중간에 멀쩡히 있었는데 그냥 지나쳤다.
    후보가 여럿일 때 _detect는 **가로지름만 보고** 골랐다. 주석이 그 근거를 적어
    두기까지 했다 — "마루·그림자는 화면을 덜 가로지른다". 그 전제가 새 무대에서
    반증됐다. 같은 프레임 실측(극성 dark):
    자주 테이프 r255-371 가로지름 86.3% separation 72.4 (V=68 S=83 H=159)
    마루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
2026-08-22 ble: IP를 알려면 SSH가, SSH를 하려면 IP가 필요했다 — 블루투스로 그 고리를 끊는다
    오늘 하루에만 젯슨 IP를 세 번 찾았다. 현장을 옮길 때마다 WiFi가 바뀌고 그때마다
    주소가 바뀌는데, 알아내려면 SSH가 필요하고 SSH를 하려면 주소가 필요하다. ARP
    스윕으로 때워 왔지만 그건 **젯슨이 이미 내가 아는 망에 붙어 있을 때만** 통한다.
    새 망밖에 없는데 젯슨은 옛 망을 찾고 있으면 모니터·키보드를 물리는 수밖에 없었다.
    블루투스는 IP 망과 무관한 경로라 이 고리를 끊는다. 그리고 여기서 `join`으로 새
    WiFi에 붙이면 된다 — **BLE 링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
2026-08-22 ble: 손님이 한 번 다녀가면 젯슨이 사라졌다 — 광고는 연결되는 순간 꺼지고 아무도 켜주지 않았다
    "블루투스가 안 된다"의 진짜 원인이었다. BLE 규격상 **연결 가능 광고는 연결이
    성립되는 순간 컨트롤러가 끈다.** 그건 정상이다. 문제는 **BlueZ가 끊긴 뒤에도 다시
    켜주지 않는다**는 것 — 그래서 한 번 붙었다 떨어지면 젯슨은 스캔에서 통째로 사라진다.
    증상이 원인을 가렸다. 폰 로그에는 "찾았습니다" 직후 10초 뒤 status 147
    (GATT_CONNECTION_TIMEOUT)만 남았고, 젯슨 bluetoothd에는 연결 시도조차 안 찍혔다.
    HCI를 떠 보니 광고 자체는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
2026-08-22 arm: "5mm만 더 앞으로"가 안 됐다 — 프리셋은 저장한 자세로 점프할 뿐이었다
    이 팔이 할 수 있는 건 "저장한 자세 재생"뿐이었다(presets.py). 그래서 문 물건을
    조금만 옮기거나 잡은 채로 돌리는 일은, 그런 자세를 미리 저장해 두지 않았으면
    방법이 없었다. 카테시안 유닛이 그 사이를 메운다.
    지금 관절값 ─FK→ 지금 집게 좌표 ─(요청한 만큼)→ 목표 좌표 ─IK→ 목표 관절값
    구성
    hardware/kinematics.py 순/역기구학. import가 math 하나뿐이라 팔도 젯슨도
    없이 개발 PC에서 검증된다 — 이게 이 파일을 따로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
2026-08-22 docs: 보드를 바꾸면 위쪽이 통째로 무너졌다 — duty 대신 물리 단위로 계약을 긋는다
    지금 젯슨은 보드에 `V vx vy w`(duty, -255..255)를 보낸다. duty는 물리량이 아니라
    **그 보드의 구현 세부사항**이다. 그래서 세 가지가 따라왔다.
    · 같은 duty가 배터리 전압에 따라 다른 속도를 낸다 → "문턱 90"이 아침저녁 다르다
    · 게인을 만지기 전에 크기를 재야 하는데 잴 단위가 없다 → 하루에 같은 병이 세 번
    · 보드를 바꾸면 duty의 뜻이 바뀌므로 위쪽 코드가 전부 무너진다
    `350mm/s`는 어느 보드에서도 같은 뜻이다. docs/보드-계약.md가 그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
2026-08-28 ros: 무대를 외운 자리에서만 딸 수 있었다 — 픽셀을 버리고 좌표로 계약을 긋는다
    지금 로봇은 토마토를 **화면 좌표**로 안다. harvest.SceneModel이 관측한 픽셀 x를
    나무 번호로 배우고, arm.play_blended(y)가 저장해 둔 자세를 보간한다. 어디에도
    미터가 없다. 그래서 무대를 옮기면 번호가 어긋나고, 서비스를 재시작하면 학습이
    날아가고, 열매가 20cm 앞으로 오면 헛집는다. 튜닝으로 못 고친다 — "토마토가 어디
    있는가"를 미터로 말할 수 없는 구조라서 그렇다.
    새 계통(ros2/)은 그 구조를 바꾼다:
    D405 (u,v,depth) ─내부파라미터→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
    [so101_arm.xacro, tomato_robot.urdf.xacro]
2026-08-28 ros: proxy 모드가 붙을 수 없는 포트를 보고 있었다 — 대시보드는 8000이 아니라 8090
    현장 점검(2026-08-28, 새 장소)에서 드러났다. 젯슨에서 듣고 있는 포트는
    80/8090/22이고 8000은 아무도 안 쓴다. config.VOICE_LOG_HTTP_PORT = 8090이
    대시보드의 실제 포트다 — 기본값을 그걸로 맞춘다.
    증상이 조용했을 것이다: arm_mode:=proxy로 띄우면 노드는 멀쩡히 뜨고
    /joint_states만 영영 안 온다. 로그에는 "대시보드에 못 붙었다"가 찍히지만
    포트가 틀렸다고는 아무도 말해주지 않는다.
2026-08-28 ros: 새 계통이 옛 계통의 껍데기였다 — 계산은 공유하되 소유권을 가져온다
    지적받은 대로다. `arm_mode`의 기본값이 `proxy`였고, 그건 레거시 웹 서비스
    (`GET /status` · `POST /cmd`)에 붙어야만 도는 경로였다. 그 상태의 "ROS 계통"은
    옛 계통 위에 씌운 껍데기일 뿐이다.
    더 나쁜 건 그게 **새 계통의 존재 이유를 정면으로 부정**한다는 것이었다. ROS를
    쓰기로 한 까닭 중 하나가 시간이었다 — 깊이 프레임과 관절값은 다른 시각의
    데이터라 *그 프레임을 찍은 순간의* 자세로 풀어야 한다. proxy는 남의 프로세스에
    10Hz로 물어본 값이라 "언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
2026-08-28 docs: 자체검증 개수 갱신 (56 → 69종, [경계] 검사 추가분)
2026-08-28 ros: 젯슨에서 처음 빌드했더니 세 군데서 죽었다 — 전부 "증상이 원인을 안 가리키는" 종류
    지금까지 ROS 코드는 **한 번도 빌드된 적이 없었다.** 자체검증 69종이 통과해도
    그건 내가 파일을 읽어 계산한 결과일 뿐이라, colcon이 도는지·런치가 뜨는지는
    아무것도 말해 주지 않는다. 젯슨(Ubuntu 24.04 noble/arm64)에 올려 실제로 돌렸고,
    세 군데서 죽었다. 셋 다 로그가 원인을 안 가리키는 종류였다.
    ① `entrypoint.sh`의 `set -u`가 ROS를 죽였다
    /opt/ros/jazzy/setup.bash: line 8: AMENT_TRACE_SETUP_FILES: unbound variable
    ROS 환경 스크립트는 미정의 변수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
    [so101_arm.xacro]
2026-08-31 ros: 팔을 직접 잡는 길이 네 군데서 막혀 있었다 — 두 계통이 같은 집게 좌표를 말한다
    3~4단(실물 팔) 검증. `arm_mode:=direct`가 코드로는 맞았지만 **한 번도 실행된 적이
    없어서**, 컨테이너에서 팔에 닿기까지 네 군데가 막혀 있었다. 넷 다 로그가 원인을
    안 가리키거나, 엉뚱한 곳을 가리켰다.
    ① `No module named 'lerobot'`
    lerobot은 컨테이너에 없다. 젯슨의 ~/lerobot/.venv(2.0G)에 있고, 그 venv의
    파이썬이 3.12.3으로 컨테이너(우분투 24.04)와 같아 그대로 읽힌다.
    compose가 읽기전용으로 물리고 TOMATO_LEROBOT=/lerobot 로 알려준다.
    ⚠ PYTHONP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
2026-08-31 ros: 카메라가 손목에 붙어 있었다 — 그런데 보정 결과를 팔 밑동에 매달고 있었다
    내가 장착 방식을 잘못 알고 있었다. D405는 삼각대가 아니라 **5번 관절(wrist_roll)
    뒤, 집게 바로 위**에 볼트로 붙어 집게 앞을 본다(컬러 화면 아래의 검은 덩어리가 그
    집게다). 즉 `fixed`가 아니라 `on_arm`이다. 차체 고정용 ORBBEC Astra Pro는 아직 안 왔다.
    그 오해가 코드 버그 하나를 덮고 있었다.
    `on_arm`이 푸는 값은 `T_tool_cam`인데 `_broadcast()`가 그걸 **항상
    `parent_frame`(arm_base)에 매달고** 있었다. 그러면 카메라 프레임이 팔 밑동에
    박혀 손목을 따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
    [ros_selfcheck.py]
2026-08-31 ros: 카메라를 넘긴 적이 없었다 — compose를 다시 쓰면서 video 장치를 통째로 빠뜨렸다
    5~6단(카메라·검출) 검증. `No RealSense devices were found!` 로 막혀 있었는데,
    원인은 librealsense도 D405도 아니고 **내가 compose를 다시 쓸 때 장치 설정을
    지워 버린 것**이었다. `/dev/bus/usb`만 남고 video 노드도 device_cgroup_rules도
    없었다. 카메라를 안 넘겨 놓고 카메라를 기대한 셈이다.
    왜 노드 하나만 적으면 안 되나 — D405는 V4L2 노드를 **여섯 개** 쓴다(지금 video3~8).
    librealsense는 /sys/class/video4linux 를 훑어 이름을 얻은 뒤 그 이름으로 /dev/videoN
    을 여는데,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
2026-08-31 tools: 보정 전에 깊이 사슬부터 쟀다 — 아는 길이 100/174.5mm로
    손-눈 보정은 "카메라 좌표 → 팔 좌표"를 푼다. 그 **앞 단계**가 맞는지는 아무도
    재 본 적이 없었다. 거기가 틀려 있으면 보정이 그 오차를 그대로 흡수해서
    **잔차는 작게 나오고 팔은 헛집는다** — 가장 찾기 어려운 실패다.
    벽에 붙인 흰 종이의 검은 점 네 개(가로 100mm, 세로 174.5mm, 카메라에서 390mm)로
    쟀다. depth-cam이 도는 채로 /dev/shm을 읽으므로 ROS도 컨테이너도 서비스 정지도
    필요 없다.
    위 가로 99.8 / 아래 가로 99.0 (기대 100.0)
    왼 세로 173.8 / 오른 세로 173.5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
2026-08-31 tools: 손-눈 보정을 관절공간으로 — 그리고 왜 아직 안 되는지 (실측 기록)
    대시보드 경로가 세 군데서 막혀 있어서, 이동·촬영·풀이를 스스로 하는 도구를 만들었다.
    ① 좌표 이동이 막힌다 — 카메라가 벽의 표적을 보려면 팔이 몸통 위로 접혀야 하고,
    그 자세의 signed_radius가 15mm라 cartesian이 모든 이동을 거절한다(가드는
    "지금 자세"를 본다). → 관절공간으로 움직인다(arm_extend.py, handeye_collect.py).
    ② 뻗으면 서보가 놓는다 — r≈260mm, pitch 50° 부근에서 **"갑자기 힘이 추욱"**
    빠졌다. servo_diag.py로 확인: 전압 12.1~12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
2026-08-31 tools: 경로도 안전 검사 대상이다 — 출발지도 목적지도 안전한데 가는 길이 위험했다
    내려다보는 자세(TCP 160,0,120 · pitch -70 · r=160mm)로 옮기려다 두 번 실패했다.
    목적지는 안전하고 출발지도 안전한데 **선형 보간이 중간에 팔을 최대로 편다** —
    r이 277mm까지 부풀었고 거기서 서보가 놓았다(추종 오차 5.8° → 13.5° → 22.9°).
    과부하가 났던 바로 그 구간이다.
    arm_stage.py — 관절을 **하나씩** 목표로 옮긴다. 같은 이동의 최대 r이 277 → 222mm.
    마지막 링크(95mm)가 수평을 지날 때 r이 가장 부푸므로, 그때 앞의 두 링크가 최대한
    접혀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
2026-08-31 kin: 링크 길이를 처음으로 실측했다 — l3가 95가 아니라 168mm였다
    CLAUDE.md가 계속 경고하고 있던 그것이다: "⚠ 자로 재서 고쳐라 — 기본값은 SO-101
    도면 근사치다." 아무도 이 팔을 잰 적이 없었고, 그 오차가 손-눈 보정을 어떤
    강체 변환으로도 못 풀게 만들고 있었다.
    z0 55.0 → 119.5 (+117%) 마운트 평면 → 2번(shoulder_lift) 혼 중심
    l1 116.0 → 116.5 (+0.4%)
    l2 135.0 → 138.0 (+2.2%)
    l3 95.0 → 168.0 (+77%) 4번 혼 중심 → 집게가 무는 지점
    최대 사거리 346 → 422mm
    l3의 1.77배가 카메라로 잰 불일치 1.8배와 정확히 맞아떨어졌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
2026-08-31 tools: 과부하로 놓는 게 어느 관절인지 재 봤다 — 어깨가 아니라 손목이었다
    "갑자기 힘이 추욱" 빠지는 원인을 무부하 상태에서만 보고 있었다. 그때는 전압도
    부하도 전부 0으로 보여 셋(전원 부족 / 특정 관절 한계 / 물리적 한계)이 다
    그럴듯했다. **뻗는 동안** 재니 갈렸다.
    레지스터가 구조를 말해 준다:
    Torque_Limit 1000 ← 100%. **설정으로 묶어 둔 게 아니다**
    Overload_Torque 80 부하 80%가
    Protection_Time 200 2초 지속되면
    Protective_Torque 20 토크를 **20%로 떨어뜨린다** ← 이게 "추욱"이다
    부하를 재니: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
2026-08-31 kin: d0를 쟀다 — 2번 축이 pan축보다 31.5mm **뒤**에 있다 (음수)
    마지막 남은 미측정 값. `d0`는 pan=0에서 팔이 뻗는 방향(+x)으로 재므로
    **뒤쪽이면 음수**다 → d0 = -31.5mm.
    최대 사거리 422 → 391mm
    교시 자세(곧게 위로) TCP = (-31.5, 0, 542) — **pan축 바로 위가 아니다**
    이 값은 pan과 함께 도는 항이라 자세마다 다르게 기여한다. 0으로 두고 있던 동안
    손-눈 보정이 자세마다 다르게 틀렸고, 그게 잔차로 나타났다.
    레거시 자체검증이 d0=0을 가정하고 있어 같이 고쳤다:
    · "집게가 회전축 바로 위" → 이제 수평위치는 d0다
    · 세운 자세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
2026-09-02 잡기: 표적은 사람이 찍고, 조작은 전부 웹 API 하나로 — 조작대를 세웠다
    서보는 화소오차 144→8까지 여러 번 말끔히 수렴했는데 겨눈 것이 선반의 주황
    안전조끼였고, 다음엔 책상에 떨어져 있던 다른 열매였다. 알고리즘이 아니라
    **표적 선택**이 틀렸다. 화면에 빨간 것이 넷이나 있는데 어느 것을 노려야 하는지는
    사람만 안다. 그래서 젯슨이 직접 띄우는 조작대(click_server, :8090)에서 줄기를
    한 번 찍게 하고, 로봇은 그 점을 템플릿 정합으로 따라간다.
    같은 문으로 자세·조그·집게·잡기도 다 내린다 — 화면 버튼과 curl과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
2026-09-02 조작대: tomato-voice 가 살아 있으면 빨간 경고를 띄운다
    인수인계 직전에 tomato-voice(레거시 대시보드)가 되살아나 있었다 — enabled 라
    재부팅하면 돌아온다. 그게 팔 포트를 쥐고 있으면 조작대에서 시키는 일이 전부
    **조용히** 실패한다. 조용한 실패가 이 로봇의 1번 병이라, /state 에 voice 를
    싣고 화면 맨 위에 경고를 띄운다.
    인수 상태도 문서에 적었다 — 팔은 대기 자세, 집게 열림, 파일 md5 일치.
